drewsum/PIC32MZ_ETH_Demo/README.md

# PIC32MZ_ETH_Demo
A DIY dev board for PIC32MZ EF Ethernet Development
