drewsum/PIC32MZ_ETH_Demo/hdw/PIC32MZ_ETH_Demo/PIC32MZ_ETH_Demo.pdf

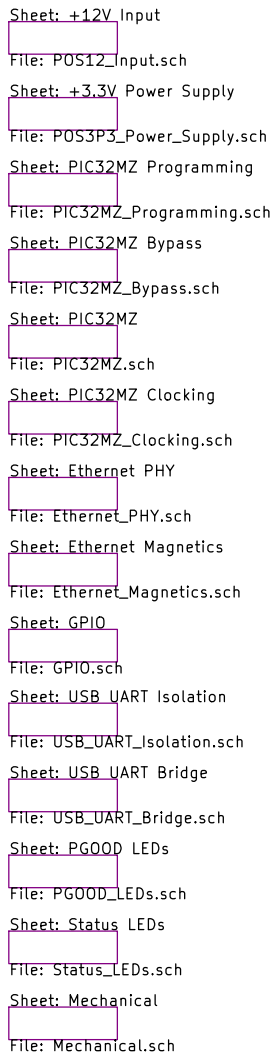
[picture p1: page 1]

File: PIC32MZ.sch Sheet: PIC32MZ Clocking

File: PIC32MZ_Clocking.sch Sheet: Ethernet PHY

File: Ethernet_PHY.sch Sheet: Ethernet Magnetics

File: Ethernet_Magnetics.sch Sheet: GPIO

File: GPIO.sch Sheet: USB UART Isolation File: USB_UART_Isolation.sch Sheet: USB UART Bridge

File: USB_UART_Bridge.sch Sheet: PGOOD LEDs File: PGOOD_LEDs.sch Sheet: Status LEDs File: Status_LEDs.sch Sheet: Mechanical File: Mechanical.sch

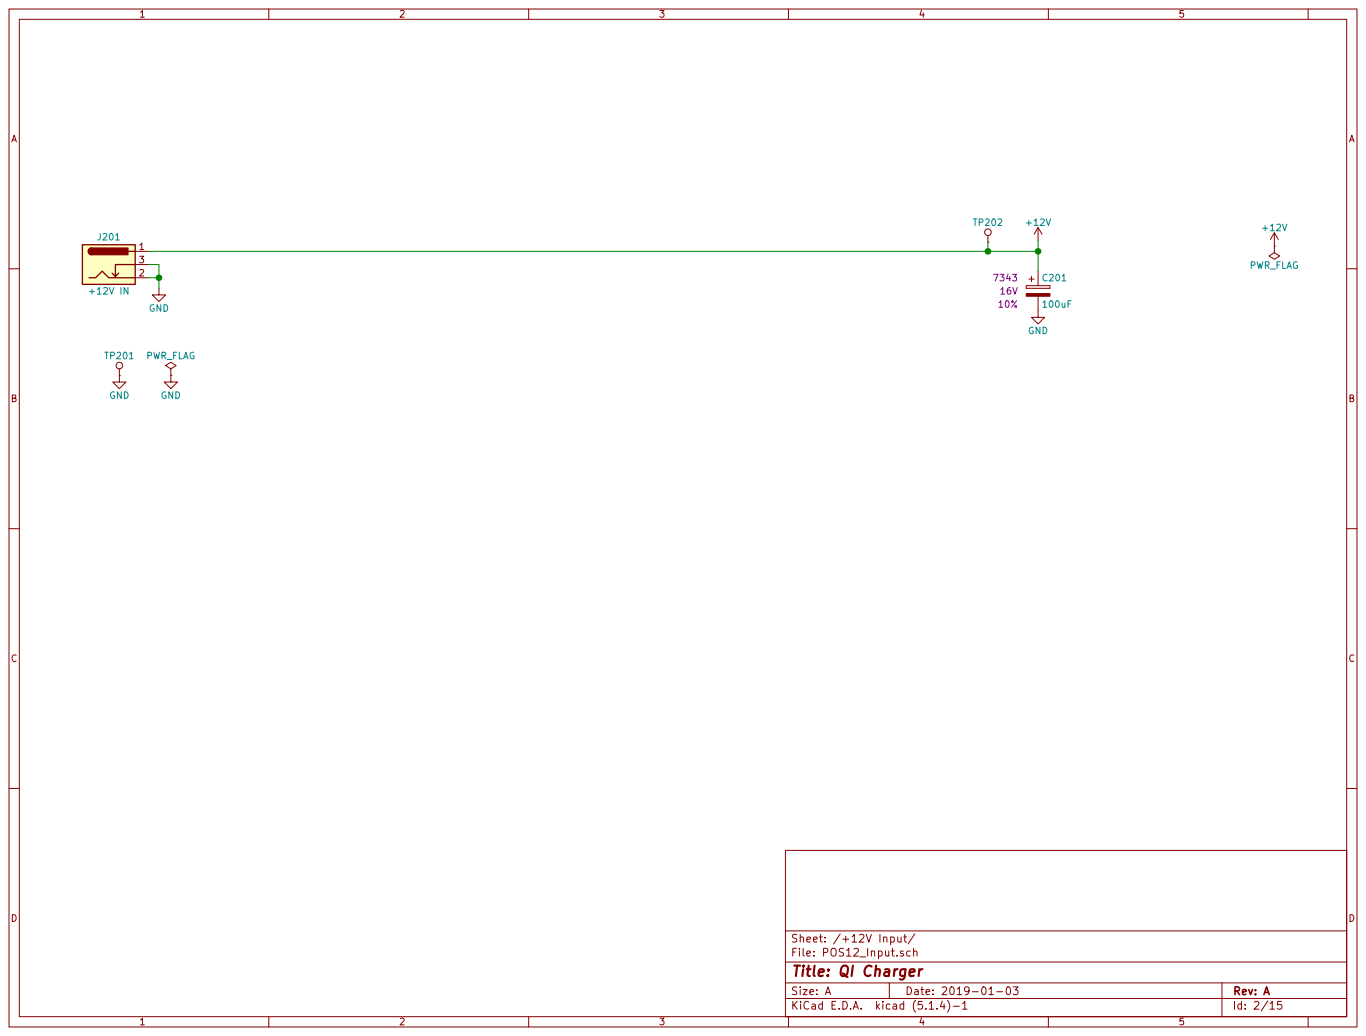
[picture p2: page 2]

Sheet: /+12V Input/
File: POS12_Input.sch
Id: 2/15 Title: QI Charger

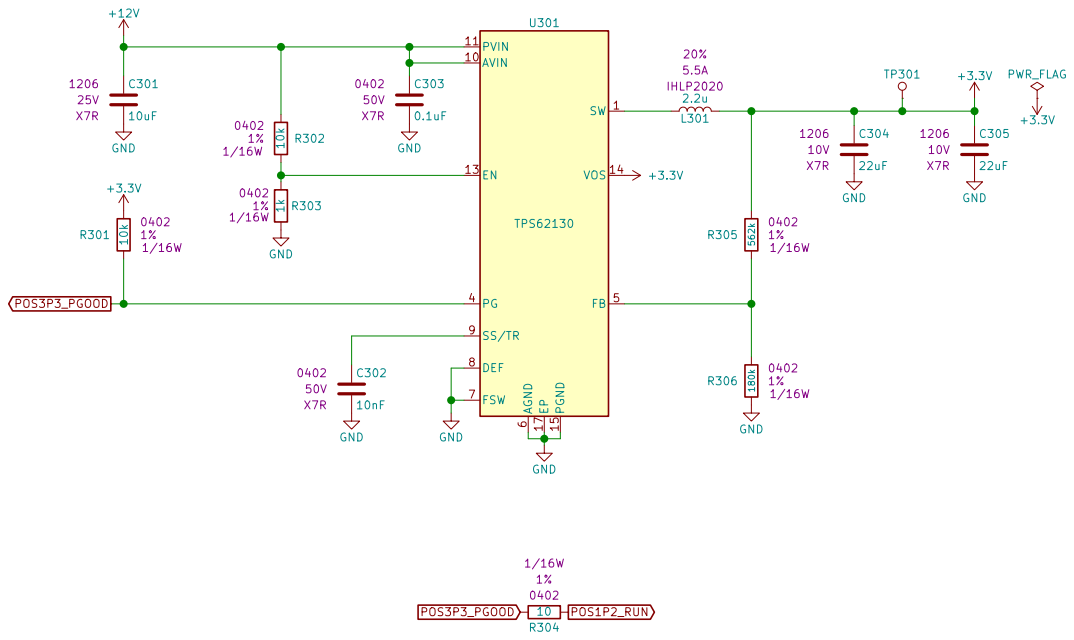
[picture p3: page 3]

6 FSW 7 DEF 8 SS/TR 9 U301 TPS62130 C305

Sheet: /+3.3V Power Supply/
File: POS3P3_Power_Supply.sch
Id: 3/15 Title: QI Charger

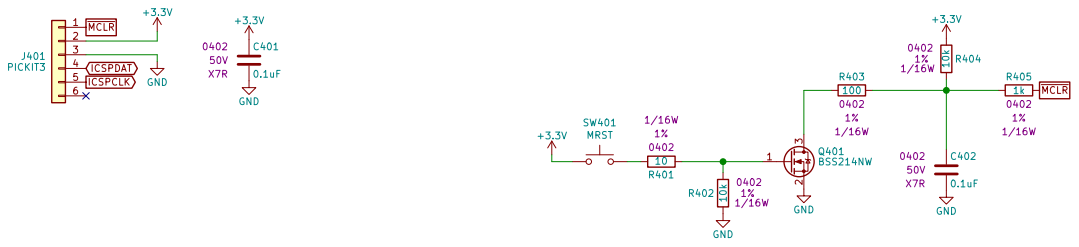
[picture p4: page 4]

Sheet: /PIC32MZ Programming/ Drew Maatman

File: PIC32MZ_Programming.sch
Id: 4/15 Title: VFD Clock

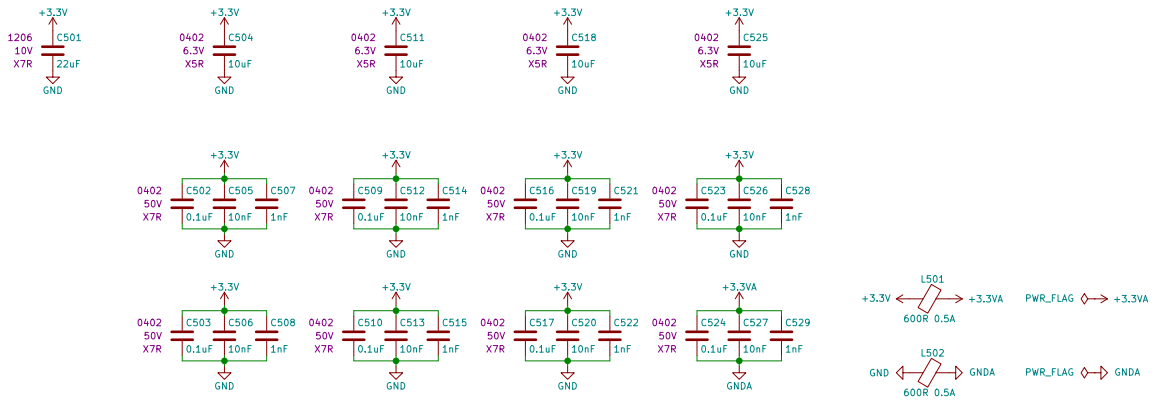
[picture p5: page 5]

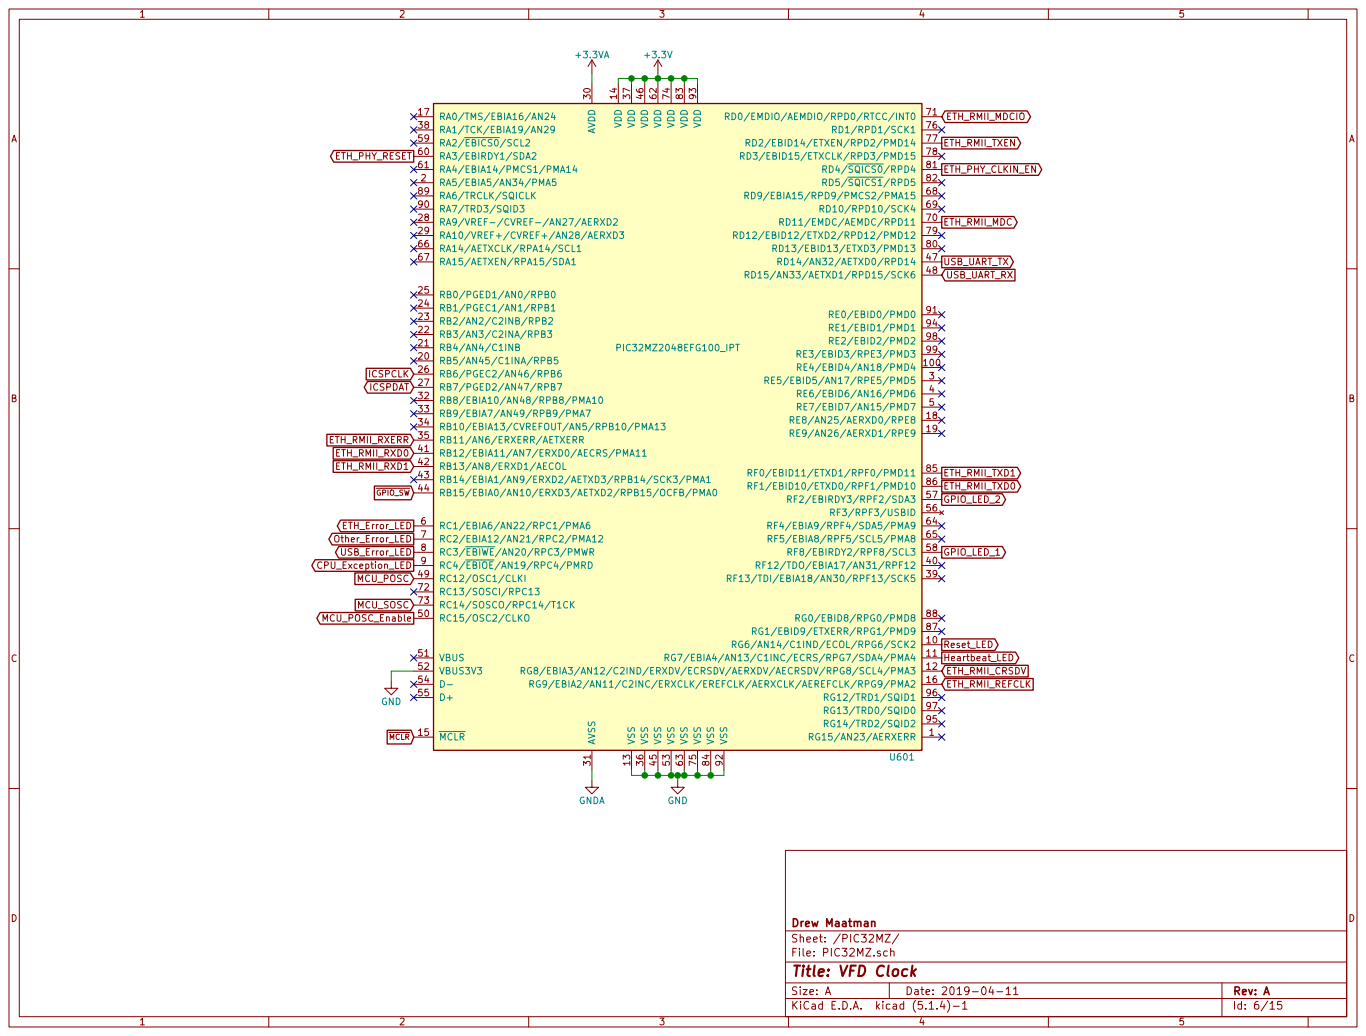
[picture p6: page 6]

Id: 6/15 Title: VFD Clock

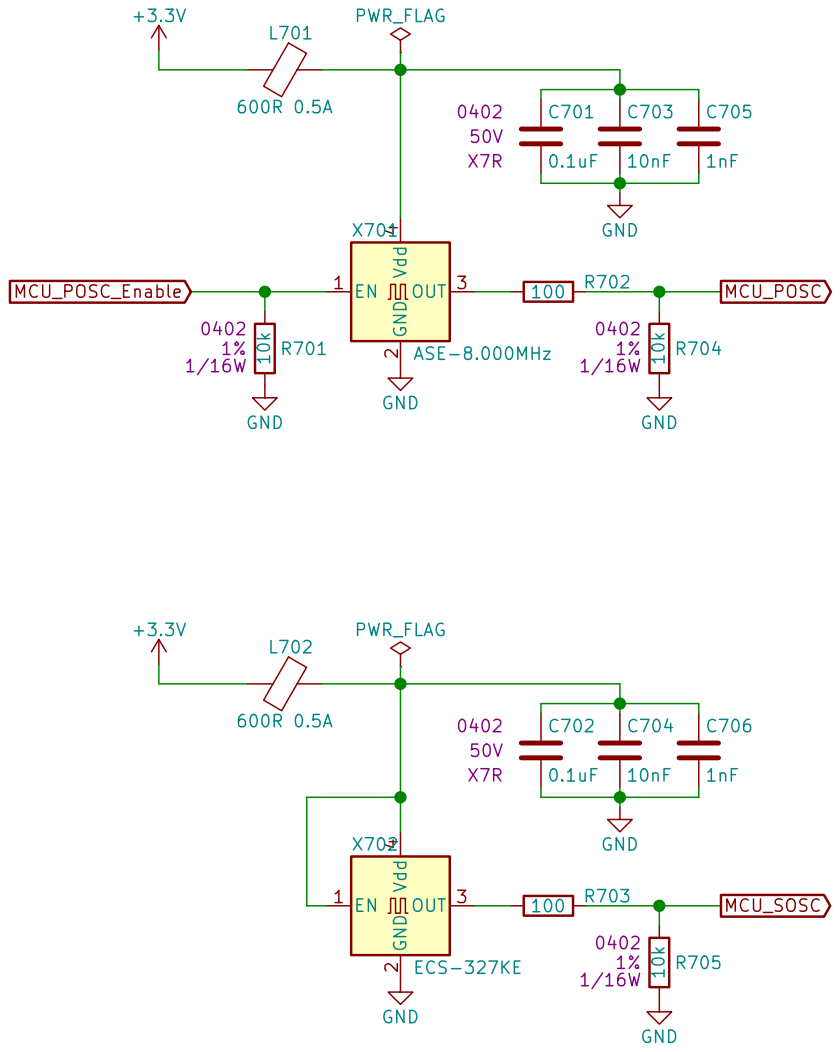
[picture p7: page 7]

2 OUT 3 Vdd X701 4 ASE-8.000MHz GND

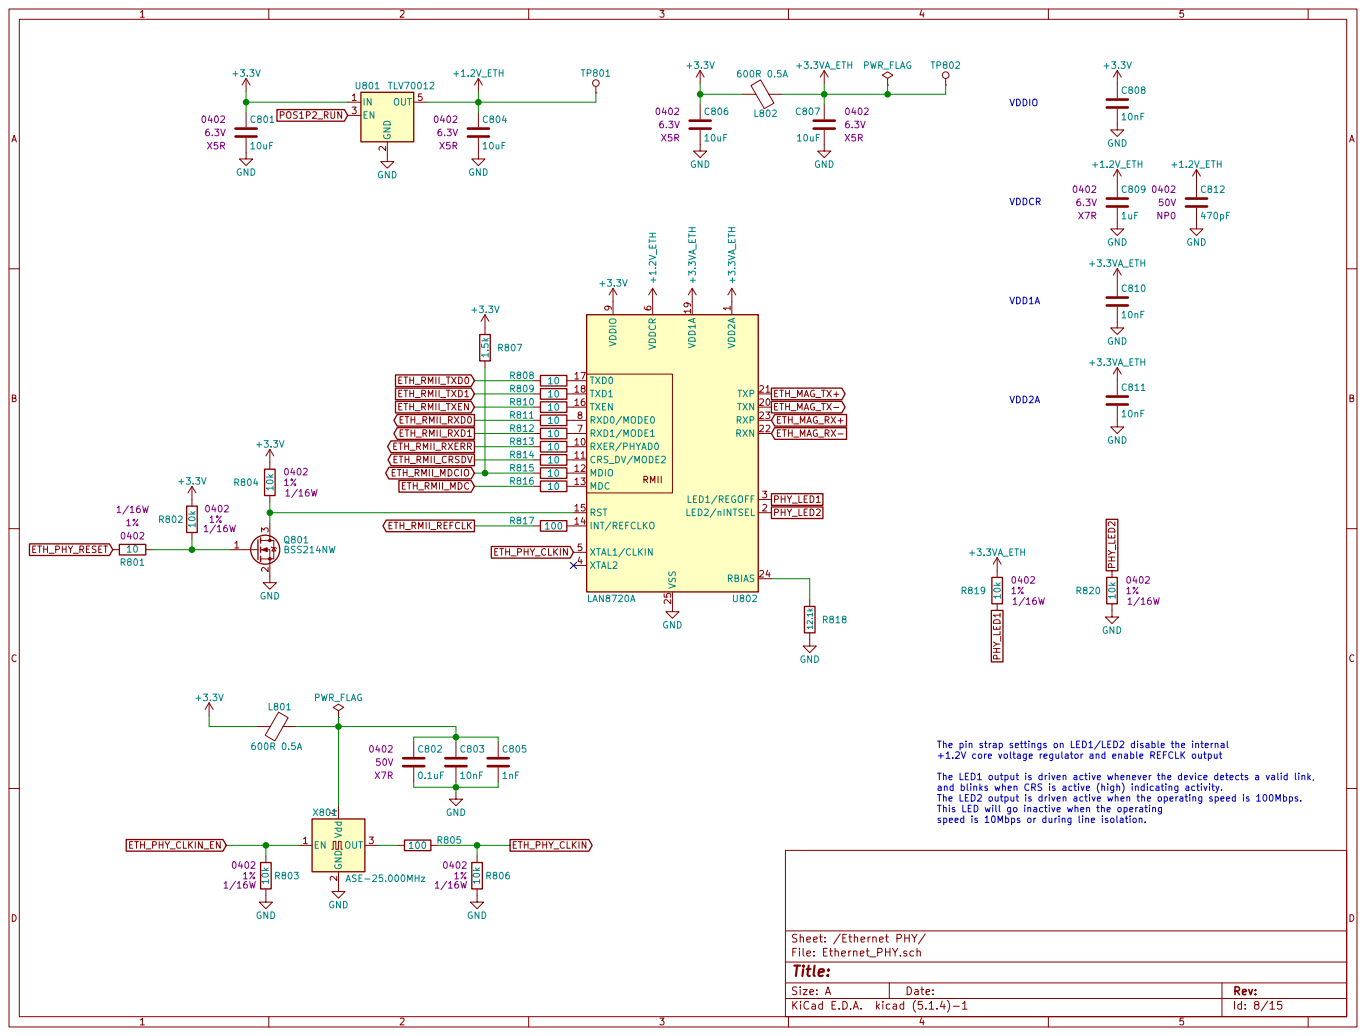
[picture p8: page 8]

The pin strap settings on LED1/LED2 disable the internal
+1.2V core voltage regulator and enable REFCLK output

The LED1 output is driven active whenever the device detects a valid link,
and blinks when CRS is active (high) indicating activity.
The LED2 output is driven active when the operating speed is 100Mbps.
This LED will go inactive when the operating
speed is 10Mbps or during line isolation.

File: Ethernet_PHY.sch Sheet: /Ethernet PHY/

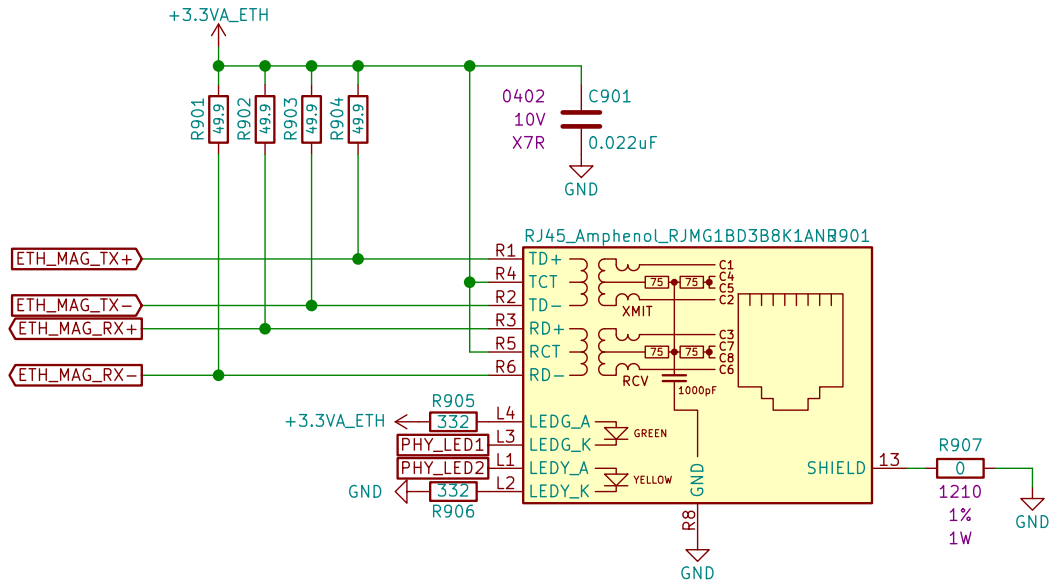
[picture p9: page 9]

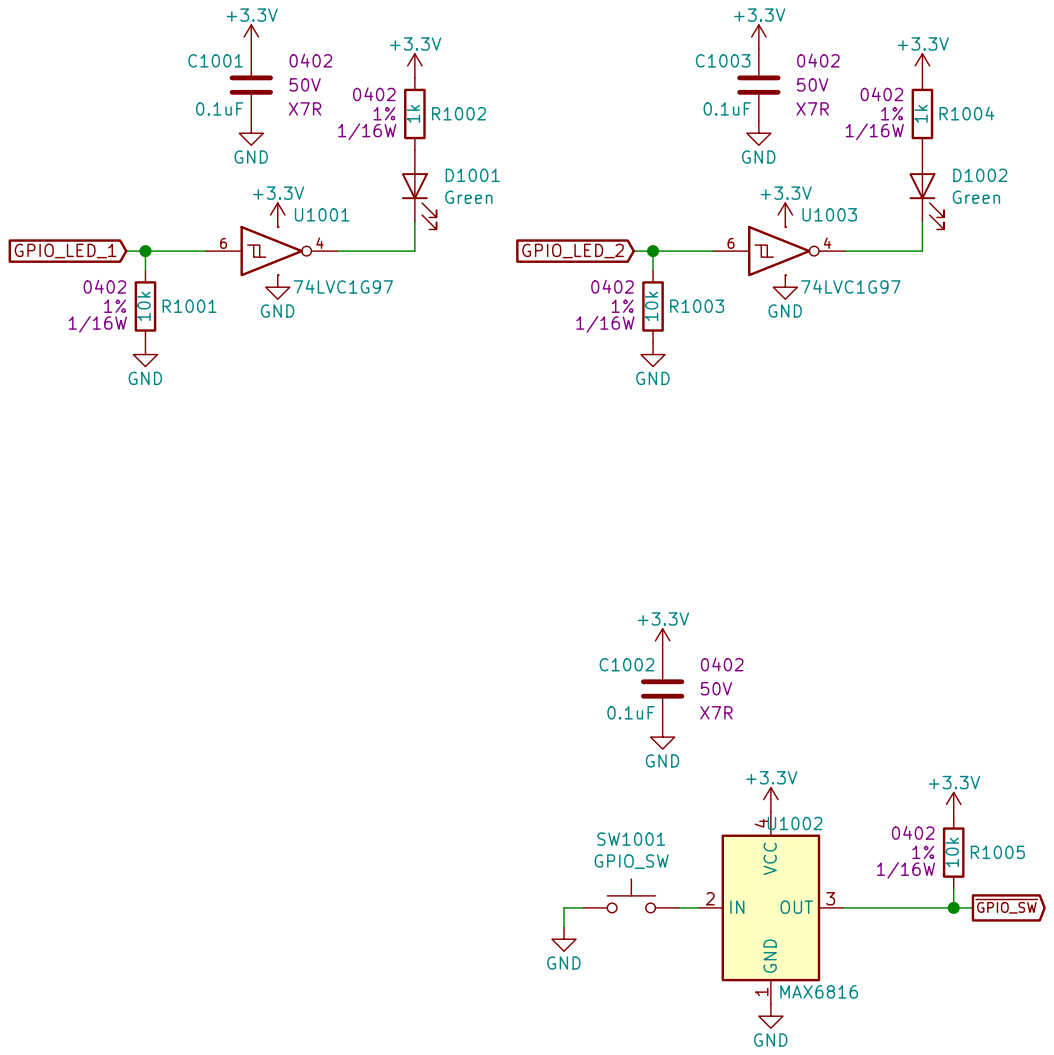
[picture p10: page 10]

Id: 10/15 Title: File: GPIO.sch Sheet: /GPIO/ GND

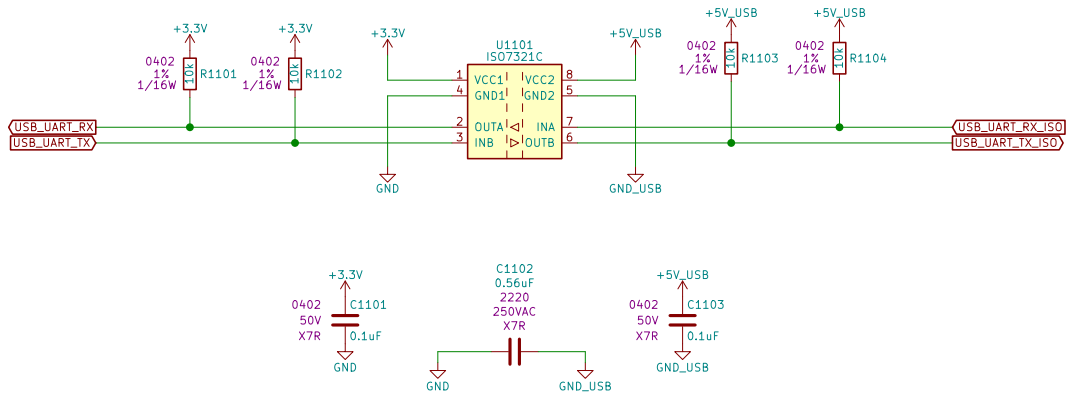
[picture p11: page 11]

Id: 11/15 Title: VFD Clock

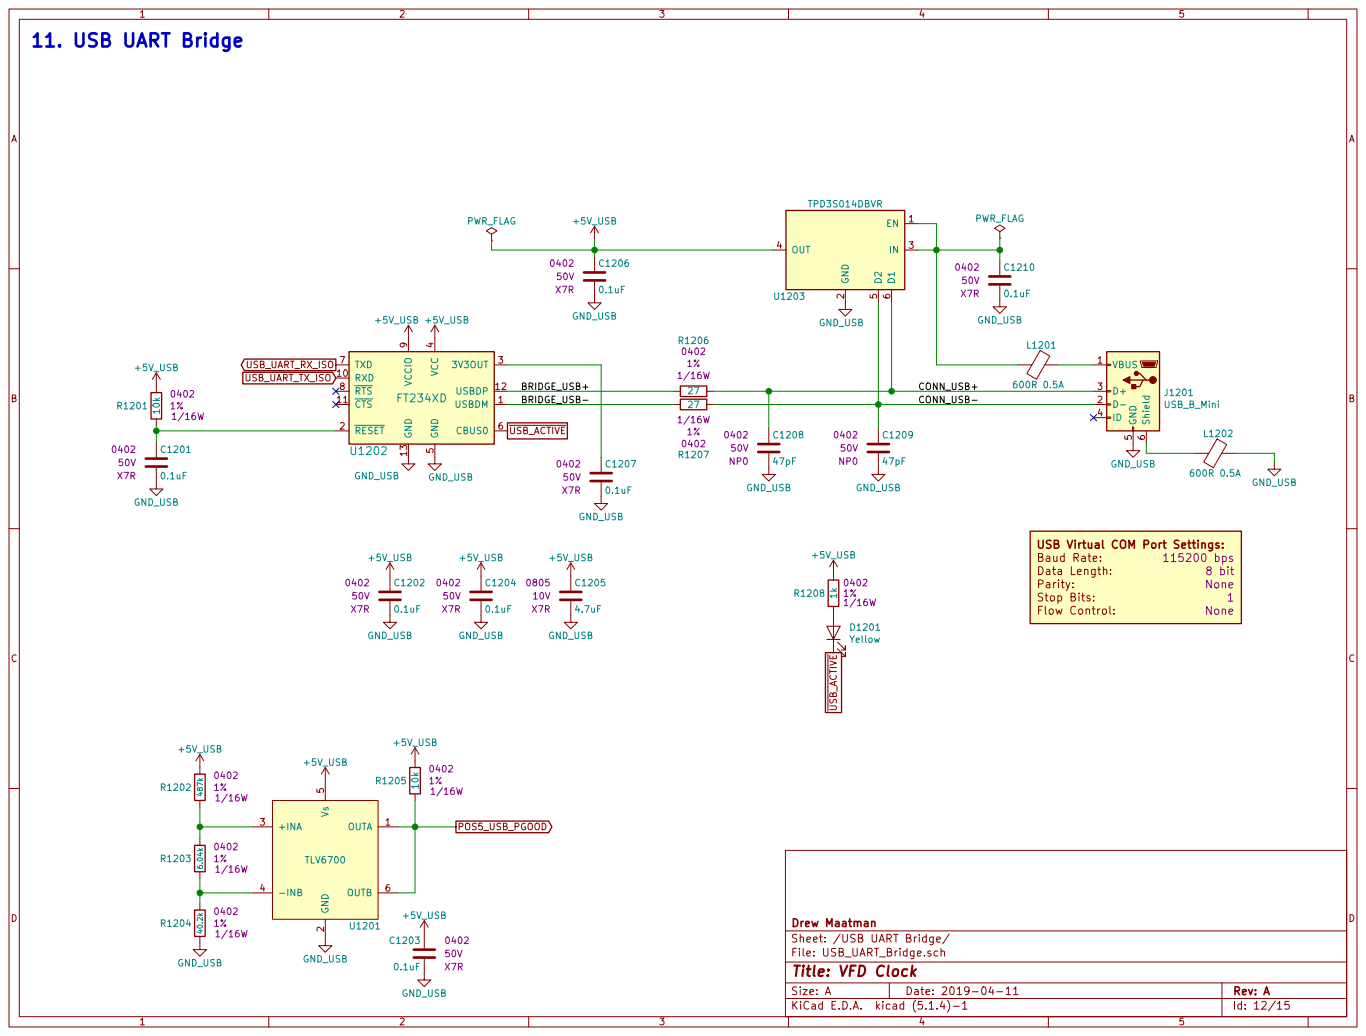
[picture p12: page 12]

USB Virtual COM Port Settings:

File: USB_UART_Bridge.sch
Id: 12/15 Title: VFD Clock

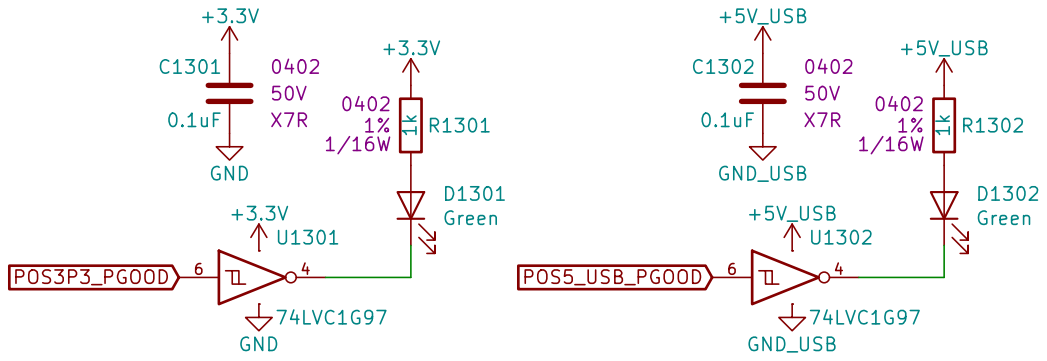
[picture p13: page 13]

File: PGOOD_LEDs.sch Sheet: /PGOOD LEDs/

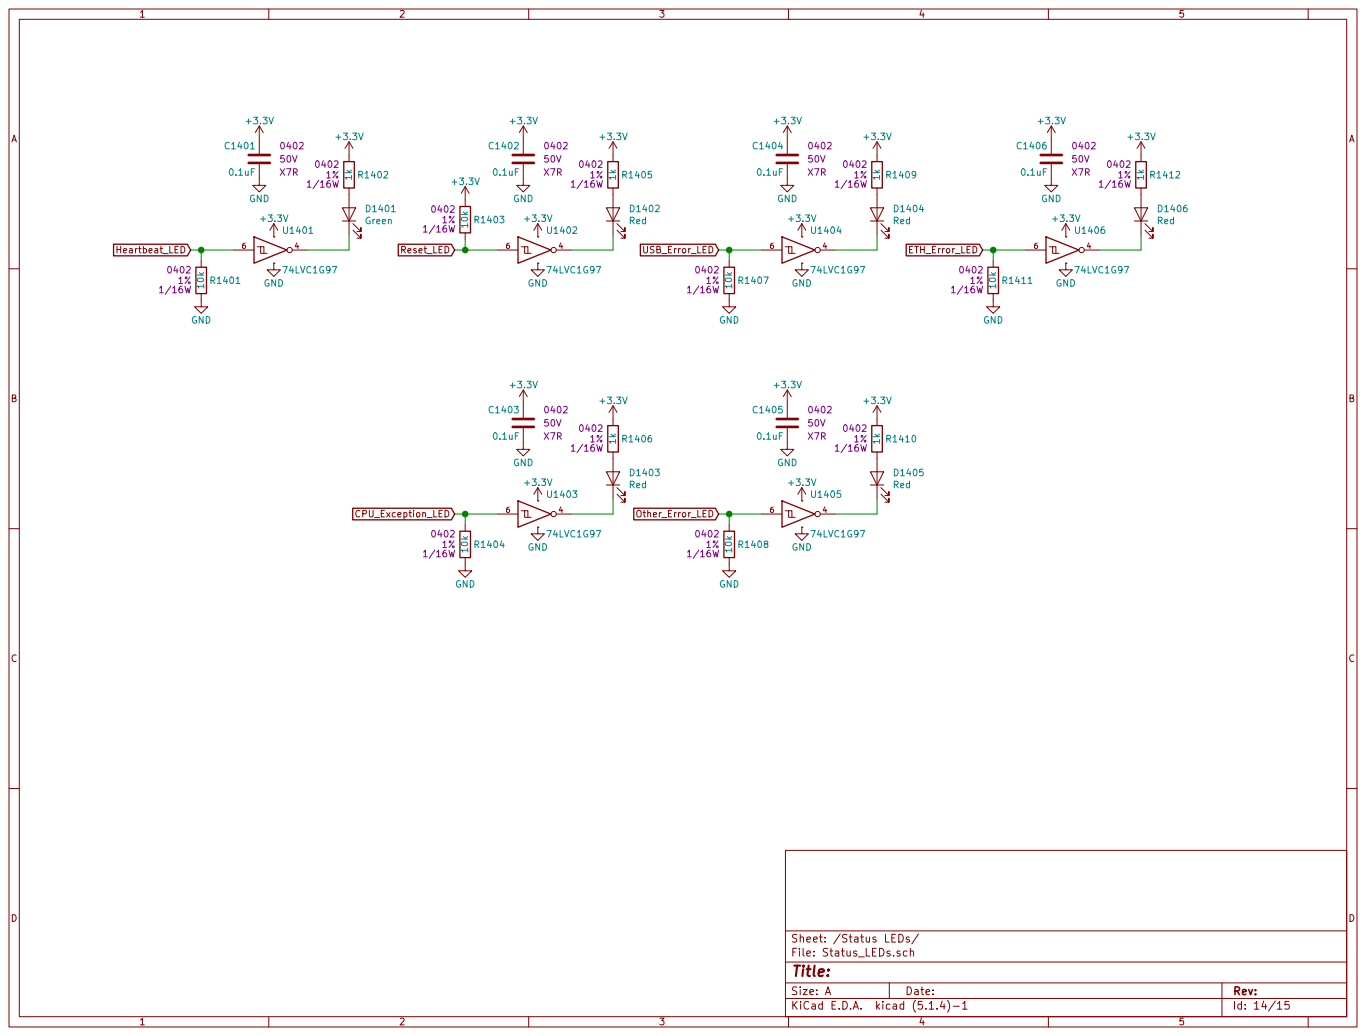
[picture p14: page 14]

File: Status_LEDs.sch Sheet: /Status LEDs/

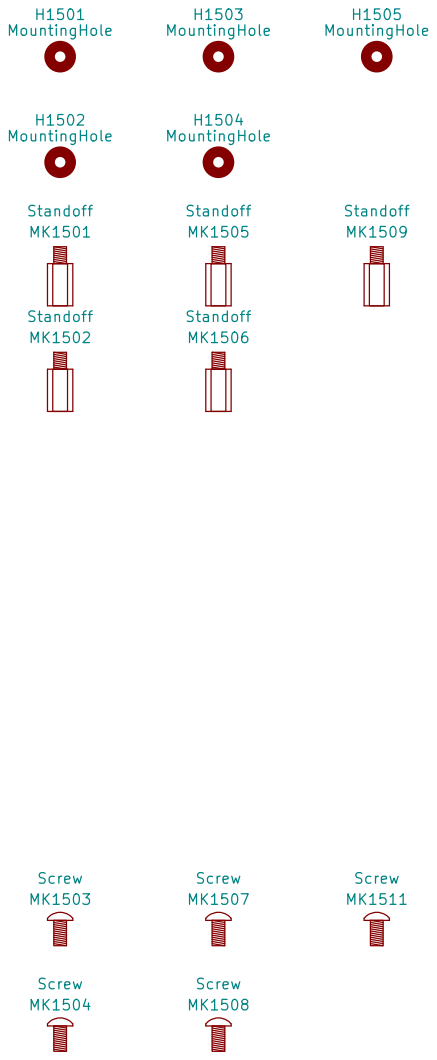
[picture p15: page 15]

File: Mechanical.sch Sheet: /Mechanical/ Drew Maatman

Id: 15/15 Title: VFD Clock
