drewsum/PIC32MZ_ETH_Demo/hdw/PIC32MZ_ETH_Demo/PIC32MZ_ETH_Demo.kicad_pcb

## KiCad design hdw/PIC32MZ_ETH_Demo/PIC32MZ_ETH_Demo.kicad_pcb (2020-06-10)

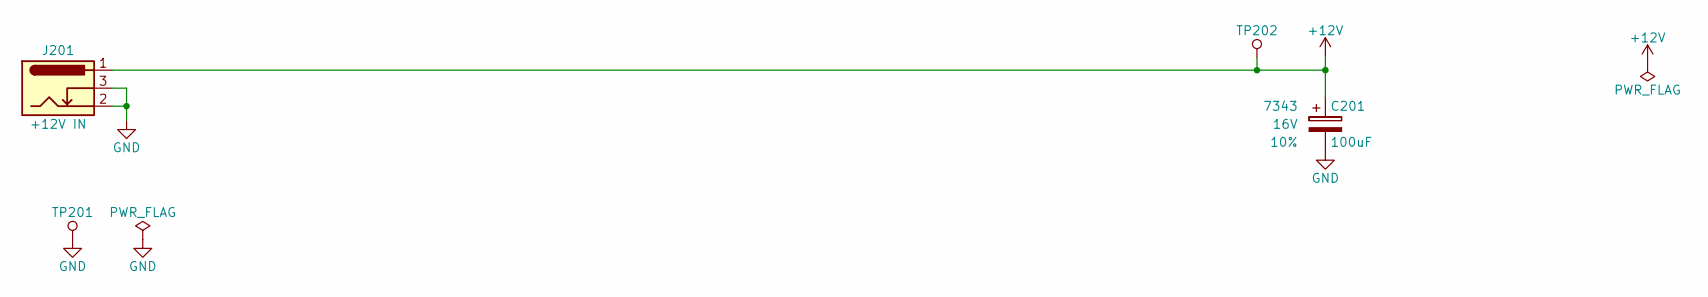
[picture p16: schematic POS12_Input.sch, QI Charger]

Parts:
C201: 100uF; CP_Tantalum_Case-X_EIA-7343-43_Reflow; Voltage 16V; Tolerance 10%; Digi-Key PN 718-1102-1-ND
J201: +12V IN; BARREL_JACK
TP201: TP; Pin_Header_Angled_1x01_Pitch2.54mm
TP202: TP; Test_Point

Connections:
+12V: C201.1, J201.1, TP202.1; also elsewhere on the board
GND: C201.2, J201.2, J201.3, TP201.1; also elsewhere on the board

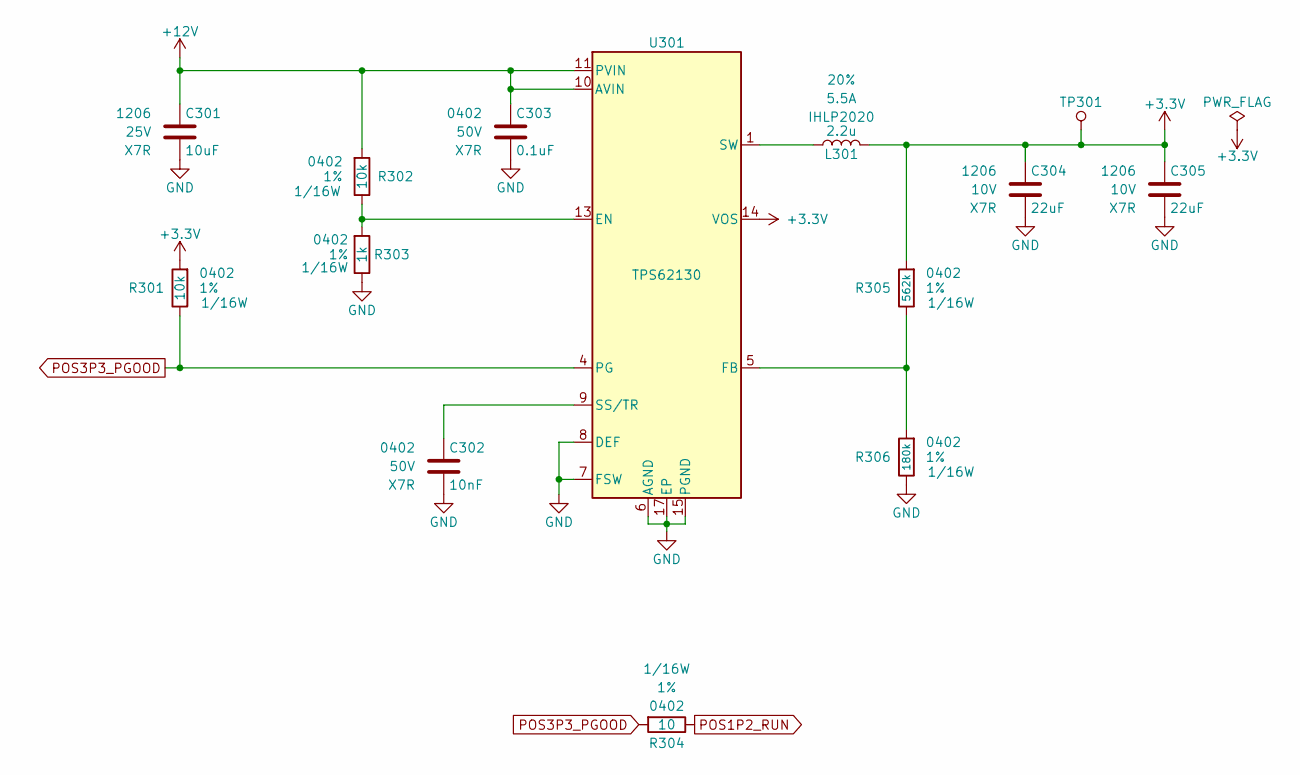
[picture p17: schematic POS3P3_Power_Supply.sch, QI Charger]

Parts:
C301: 10uF; C_1206; Voltage 25V; Digi-Key PN 1276-7031-1-ND
C302: 10nF; C_0402; Voltage 50V; Digi-Key PN 490-13295-1-ND
C303: 0.1uF; C_0402; Voltage 50V; Digi-Key PN 490-10701-1-ND
C304, C305: 22uF; C_1206; Voltage 10V; Digi-Key PN 1276-3148-1-ND
L301: 2.2u; L_Vishay_IHLP-2020; Tolerance 20%; Digi-Key PN 541-1236-1-ND
R301, R302: 10k; R_0402; Tolerance 1%; Digi-Key PN RMCF0402FT10K0CT-ND
R303: 1k; R_0402; Tolerance 1%; Digi-Key PN 541-1.00KLCT-ND
R304: 10; R_0402; Tolerance 1%; Digi-Key PN 541-3964-1-ND
R305: 562k; R_0402; Tolerance 1%; Digi-Key PN 541-562KLCT-ND
R306: 180k; R_0402; Tolerance 1%; Digi-Key PN 541-180KLCT-ND
TP301: TP; Test_Point
U301: TPS62130; QFN-16-1EP_3x3mm_Pitch0.5mm; Digi-Key PN 296-37878-1-ND

Connections:
+3V3: C304.1, C305.1, L301.2, R301.1, R305.1, TP301.1, U301.14 (VOS); also elsewhere on the board
+12V: C301.1, C303.1, R302.1, U301.10 (AVIN), U301.11 (PVIN), U301.12 (PVIN); also elsewhere on the board
GND: C301.2, C302.2, C303.2, C304.2, C305.2, R303.2, R306.2, U301.6 (AGND), U301.7 (FSW), U301.8 (DEF), U301.15 (PGND), U301.16 (PGND), U301.17 (EP); also elsewhere on the board
unnamed: C302.1, U301.9 (SS/TR)
unnamed: L301.1, U301.1 (SW), U301.2 (SW), U301.3 (SW)
unnamed: R302.2, R303.1, U301.13 (EN)
unnamed: R305.2, R306.1, U301.5 (FB)
POS1P2_RUN: R304.2; also elsewhere on the board
POS3P3_PGOOD: R301.2, R304.1, U301.4 (PG); also elsewhere on the board

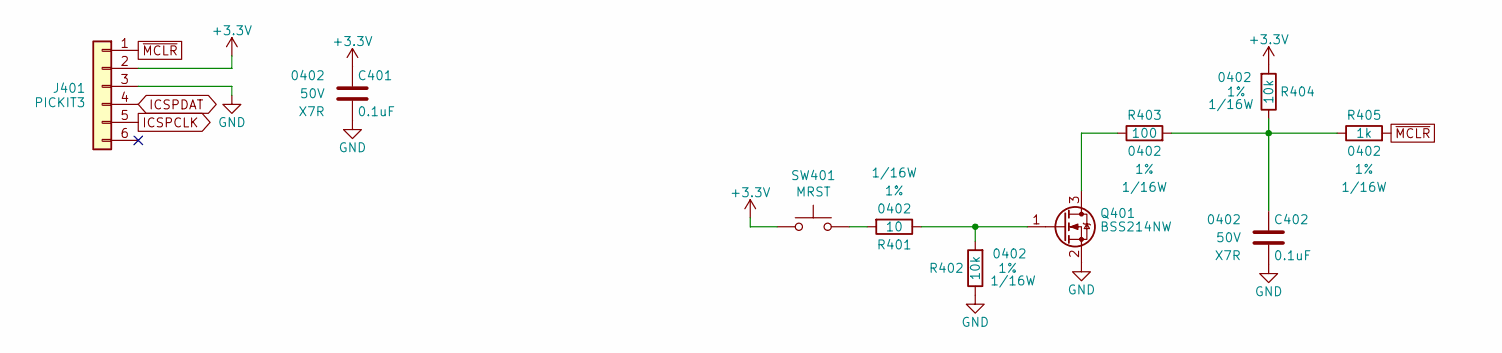
[picture p18: schematic PIC32MZ_Programming.sch, VFD Clock]

Parts:
C401, C402: 0.1uF; C_0402; Voltage 50V; Digi-Key PN 490-10701-1-ND
J401: PICKIT3; PICKIT3_Header
Q401: BSS214NW; SOT-323_SC-70; Digi-Key PN BSS214NWH6327XTSA1CT-ND
R401: 10; R_0402; Tolerance 1%; Digi-Key PN 541-3964-1-ND
R402, R404: 10k; R_0402; Tolerance 1%; Digi-Key PN RMCF0402FT10K0CT-ND
R403: 100; R_0402; Tolerance 1%; Digi-Key PN 541-100LCT-ND
R405: 1k; R_0402; Tolerance 1%; Digi-Key PN 541-1.00KLCT-ND
SW401: MRST; SW_PUSH_6mm

Connections:
+3V3: C401.1, J401.2, R404.1, SW401.1; also elsewhere on the board
GND: C401.2, C402.2, J401.3, Q401.2 (S), R402.2; also elsewhere on the board
ICSPCLK: J401.5; also elsewhere on the board
ICSPDAT: J401.4; also elsewhere on the board
unnamed: C402.1, R403.1, R404.2, R405.2
unnamed: Q401.1 (G), R401.2, R402.1
unnamed: Q401.3 (D), R403.2
unnamed: R401.1, SW401.2
~MCLR: J401.1, R405.1; also elsewhere on the board

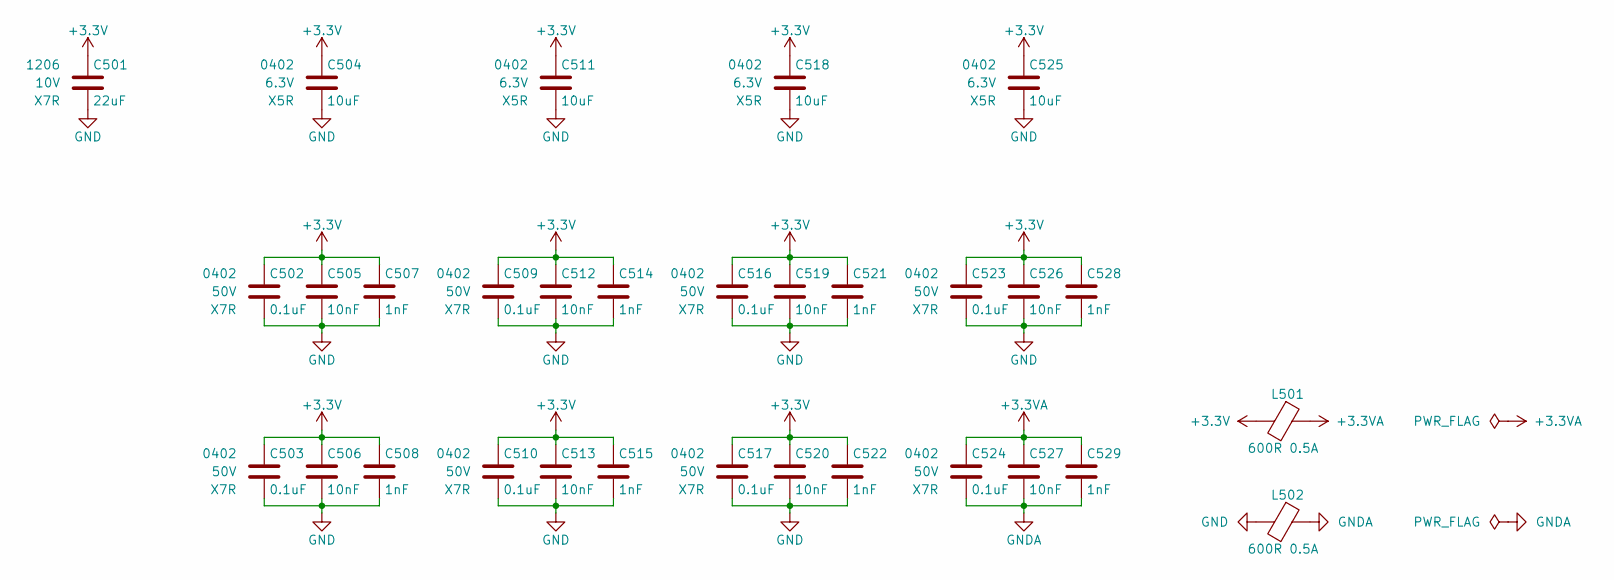
[picture p19: schematic PIC32MZ_Bypass.sch]

Parts:
C501: 22uF; C_1206; Voltage 10V; Digi-Key PN 1276-3148-1-ND
C502, C503, C509, C510, C516, C517, C523, C524: 0.1uF; C_0402; Voltage 50V; Digi-Key PN 490-10701-1-ND
C504, C511, C518, C525: 10uF; C_0402; Voltage 6.3V; Digi-Key PN 490-13211-1-ND
C505, C506, C512, C513, C519, C520, C526, C527: 10nF; C_0402; Voltage 50V; Digi-Key PN 490-13295-1-ND
C507, C508, C514, C515, C521, C522, C528, C529: 1nF; C_0402; Voltage 50V; Digi-Key PN 399-1032-1-ND
L501, L502: 600R 0.5A; L_0402; Digi-Key PN 490-5441-1-ND

Connections:
+3.3VA: C524.1, C527.1, C529.1, L501.1; also elsewhere on the board
+3V3: C501.1, C502.1, C503.1, C504.1, C505.1, C506.1, C507.1, C508.1, C509.1, C510.1, C511.1, C512.1, C513.1, C514.1, C515.1, C516.1, C517.1, C518.1, C519.1, C520.1, C521.1, C522.1, C523.1, C525.1, C526.1, C528.1, L501.2; also elsewhere on the board
GND: C501.2, C502.2, C503.2, C504.2, C505.2, C506.2, C507.2, C508.2, C509.2, C510.2, C511.2, C512.2, C513.2, C514.2, C515.2, C516.2, C517.2, C518.2, C519.2, C520.2, C521.2, C522.2, C523.2, C525.2, C526.2, C528.2, L502.2; also elsewhere on the board
GNDA: C524.2, C527.2, C529.2, L502.1; also elsewhere on the board

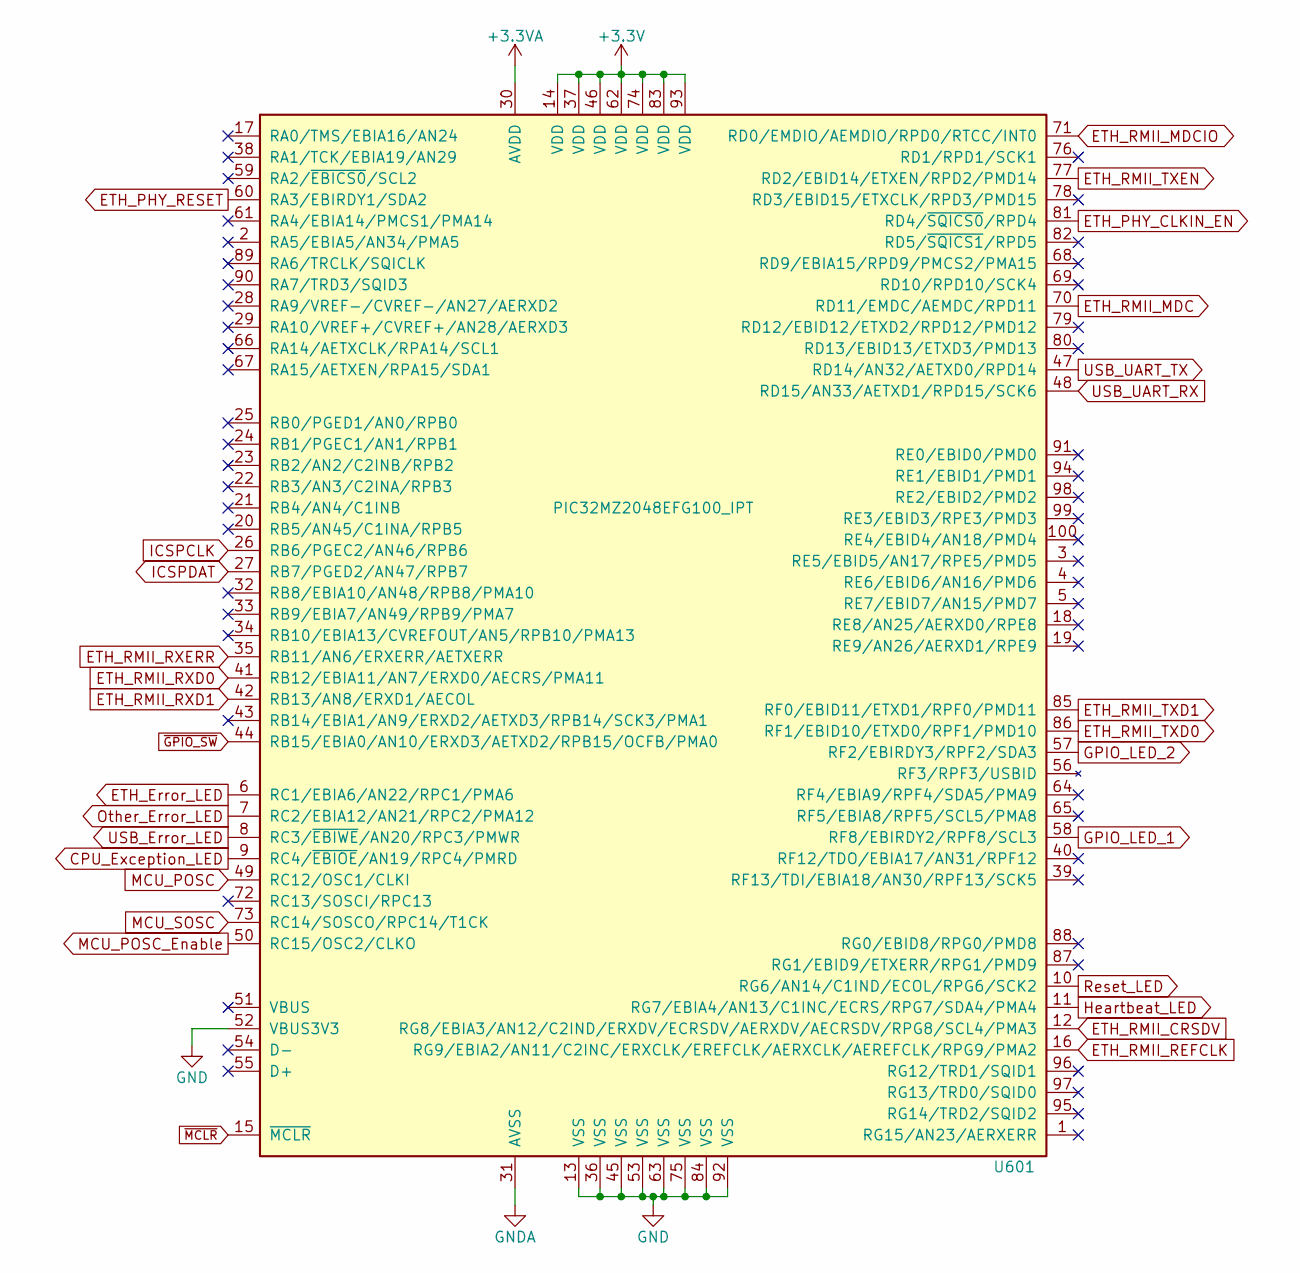
[picture p20: schematic PIC32MZ.sch, VFD Clock]

Parts:
U601: PIC32MZ2048EFG100_IPT; TQFP-100_14x14mm_Pitch0.5mm; Digi-Key PN PIC32MZ2048EFG100-I/PT-ND

Connections:
+3.3VA: U601.30 (AVDD); also elsewhere on the board
+3V3: U601.14 (VDD), U601.37 (VDD), U601.46 (VDD), U601.62 (VDD), U601.74 (VDD), U601.83 (VDD), U601.93 (VDD); also elsewhere on the board
CPU_Exception_LED: U601.9 (RC4/~EBIOE~/AN19/RPC4/PMRD); also elsewhere on the board
ETH_Error_LED: U601.6 (RC1/EBIA6/AN22/RPC1/PMA6); also elsewhere on the board
ETH_PHY_CLKIN_EN: U601.81 (RD4/~SQICS0~/RPD4); also elsewhere on the board
ETH_PHY_RESET: U601.60 (RA3/EBIRDY1/SDA2); also elsewhere on the board
ETH_RMII_CRSDV: U601.12 (RG8/EBIA3/AN12/C2IND/ERXDV/ECRSDV/AERXD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); also elsewhere on the board
ETH_RMII_MDC: U601.70 (RD11/EMDC/AEMDC/RPD11); also elsewhere on the board
ETH_RMII_MDCIO: U601.71 (RD0/EMDIO/AEMDIO/RPD0/RTCC/INT0); also elsewhere on the board
ETH_RMII_REFCLK: U601.16 (RG9/EBIA2/AN11/C2INC/ERXCLK/EREFCLK/AER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); also elsewhere on the board
ETH_RMII_RXD0: U601.41 (RB12/EBIA11/AN7/ERXD0/AECRS/PMA11); also elsewhere on the board
ETH_RMII_RXD1: U601.42 (RB13/AN8/ERXD1/AECOL); also elsewhere on the board
ETH_RMII_RXERR: U601.35 (RB11/AN6/ERXERR/AETXERR); also elsewhere on the board
ETH_RMII_TXD0: U601.86 (RF1/EBID10/ETXD0/RPF1/PMD10); also elsewhere on the board
ETH_RMII_TXD1: U601.85 (RF0/EBID11/ETXD1/RPF0/PMD11); also elsewhere on the board
ETH_RMII_TXEN: U601.77 (RD2/EBID14/ETXEN/RPD2/PMD14); also elsewhere on the board
GND: U601.13 (VSS), U601.36 (VSS), U601.45 (VSS), U601.52 (VBUS3V3), U601.53 (VSS), U601.63 (VSS), U601.75 (VSS), U601.84 (VSS), U601.92 (VSS); also elsewhere on the board
GNDA: U601.31 (AVSS); also elsewhere on the board
GPIO_LED_1: U601.58 (RF8/EBIRDY2/RPF8/SCL3); also elsewhere on the board
GPIO_LED_2: U601.57 (RF2/EBIRDY3/RPF2/SDA3); also elsewhere on the board
Heartbeat_LED: U601.11 (RG7/EBIA4/AN13/C1INC/ECRS/RPG7/SDA4/PMA4); also elsewhere on the board
ICSPCLK: U601.26 (RB6/PGEC2/AN46/RPB6); also elsewhere on the board
ICSPDAT: U601.27 (RB7/PGED2/AN47/RPB7); also elsewhere on the board
MCU_POSC: U601.49 (RC12/OSC1/CLKI); also elsewhere on the board
MCU_POSC_Enable: U601.50 (RC15/OSC2/CLKO); also elsewhere on the board
MCU_SOSC: U601.73 (RC14/SOSCO/RPC14/T1CK); also elsewhere on the board
Other_Error_LED: U601.7 (RC2/EBIA12/AN21/RPC2/PMA12); also elsewhere on the board
Reset_LED: U601.10 (RG6/AN14/C1IND/ECOL/RPG6/SCK2); also elsewhere on the board
USB_Error_LED: U601.8 (RC3/~EBIWE~/AN20/RPC3/PMWR); also elsewhere on the board
USB_UART_RX: U601.48 (RD15/AN33/AETXD1/RPD15/SCK6); also elsewhere on the board
USB_UART_TX: U601.47 (RD14/AN32/AETXD0/RPD14); also elsewhere on the board
~GPIO_SW: U601.44 (RB15/EBIA0/AN10/ERXD3/AETXD2/RPB15/OCFB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); also elsewhere on the board
~MCLR: U601.15 (~MCLR~); also elsewhere on the board

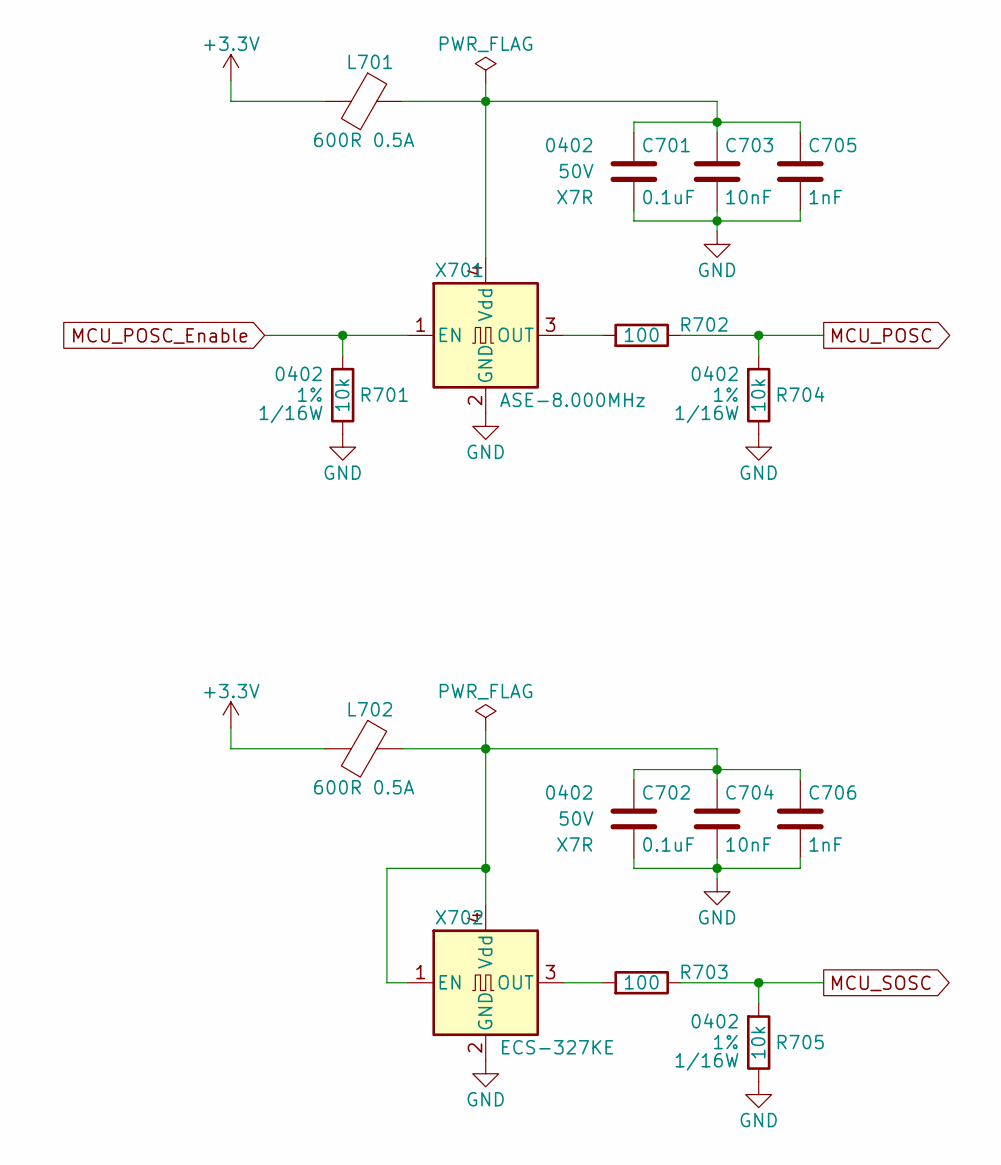
[picture p21: schematic PIC32MZ_Clocking.sch]

Parts:
C701, C702: 0.1uF; C_0402; Voltage 50V; Digi-Key PN 490-10701-1-ND
C703, C704: 10nF; C_0402; Voltage 50V; Digi-Key PN 490-13295-1-ND
C705, C706: 1nF; C_0402; Voltage 50V; Digi-Key PN 399-1032-1-ND
L701, L702: 600R 0.5A; L_0402; Digi-Key PN 490-5441-1-ND
R701, R704, R705: 10k; R_0402; Tolerance 1%; Digi-Key PN RMCF0402FT10K0CT-ND
R702, R703: 100; R_0402; Tolerance 1%; Digi-Key PN 541-100LCT-ND
X701: ASE-8.000MHz; Oscillator_SMD_Abracon_ASE-4Pin_3.2x2.5mm; Digi-Key PN 535-9558-1-ND
X702: ECS-327KE; Digi-Key PN XC1751CT-ND

Connections:
+3V3: L701.2, L702.2; also elsewhere on the board
GND: C701.2, C702.2, C703.2, C704.2, C705.2, C706.2, R701.2, R704.2, R705.2, X701.2 (GND), X702.2 (GND); also elsewhere on the board
MCU_POSC: R702.2, R704.1; also elsewhere on the board
MCU_POSC_Enable: R701.1, X701.1 (EN); also elsewhere on the board
MCU_SOSC: R703.2, R705.1; also elsewhere on the board
unnamed: C701.1, C703.1, C705.1, L701.1, X701.4 (Vdd)
unnamed: C702.1, C704.1, C706.1, L702.1, X702.1 (EN), X702.4 (Vdd)
unnamed: R702.1, X701.3 (OUT)
unnamed: R703.1, X702.3 (OUT)

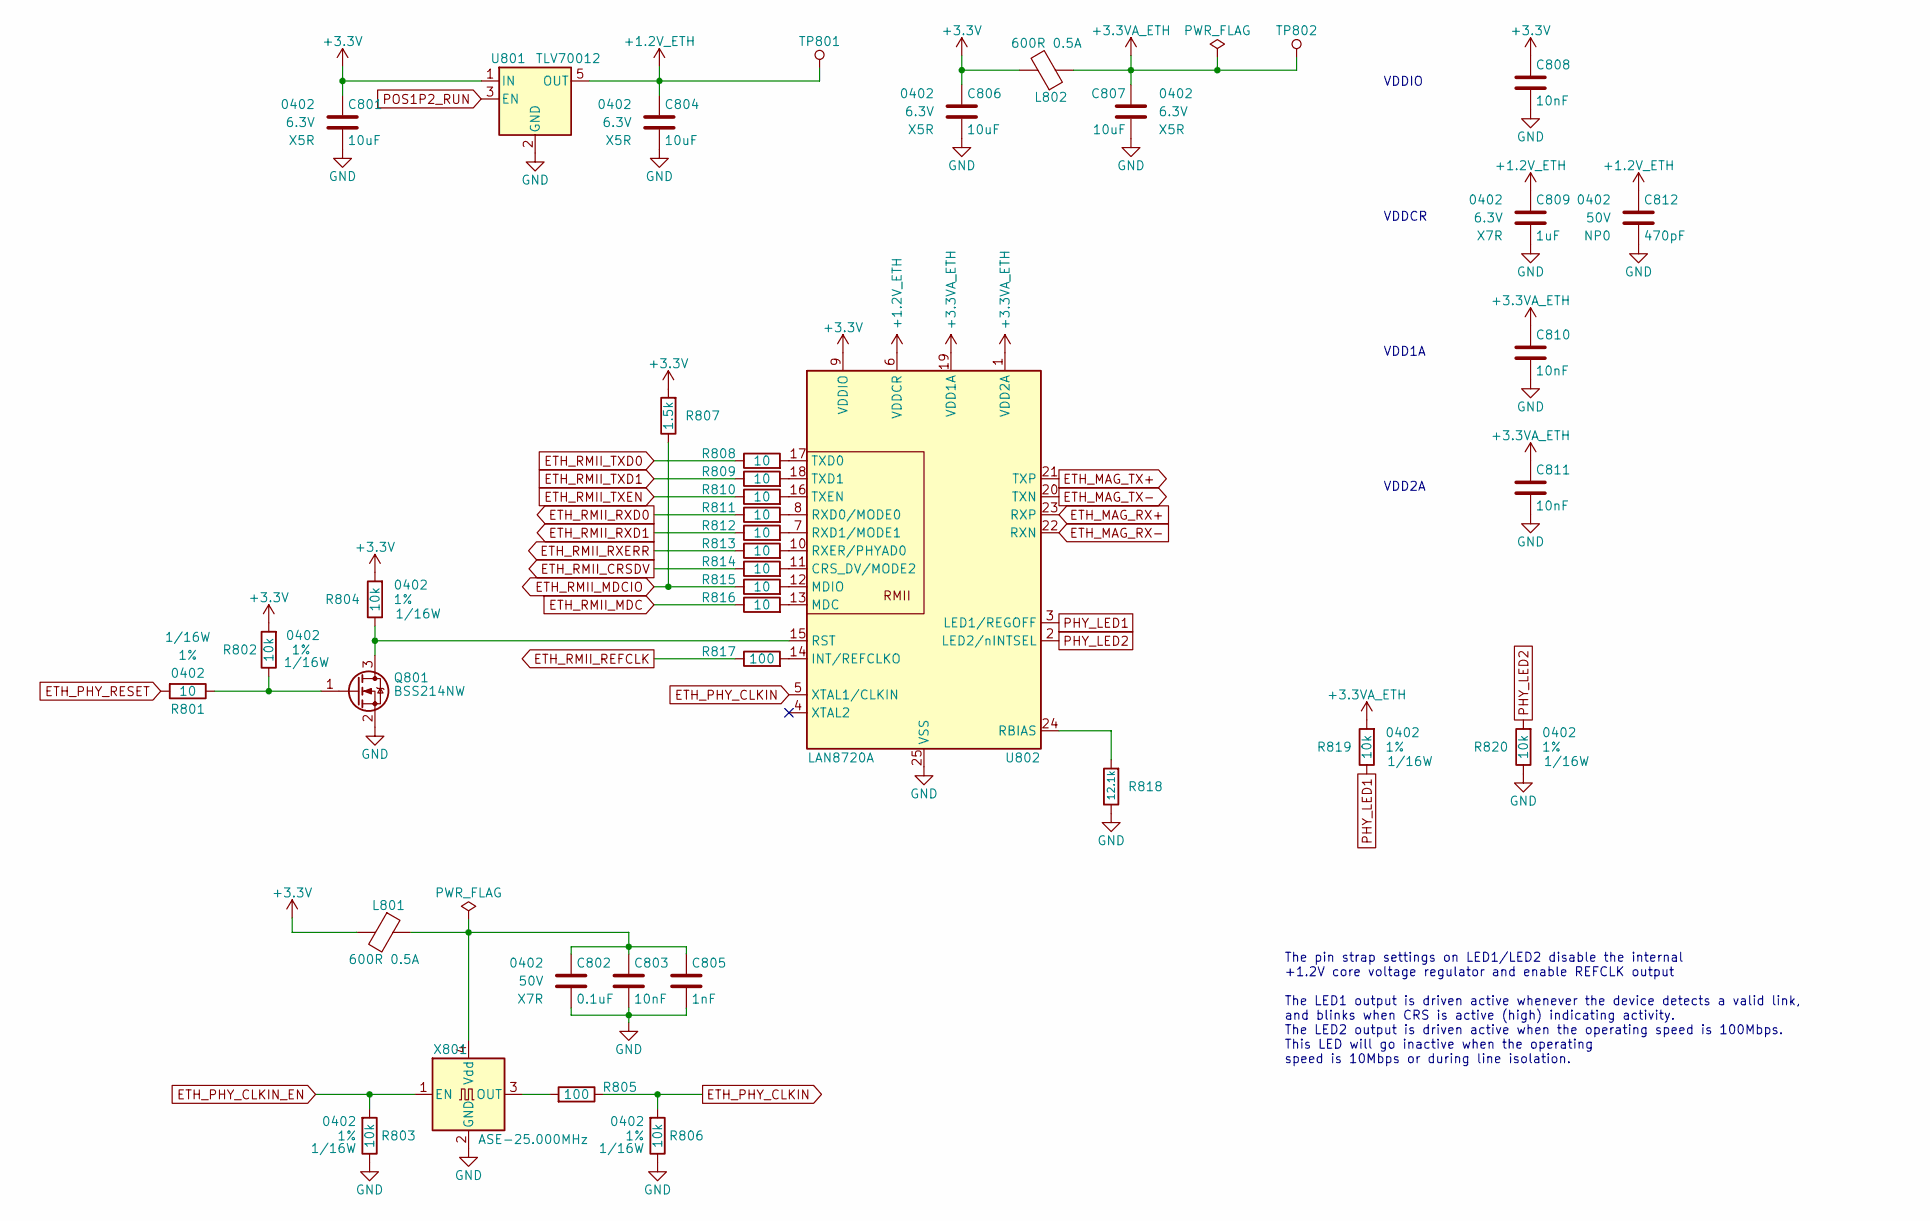
[picture p22: schematic Ethernet_PHY.sch]

Parts:
C801, C804, C806, C807: 10uF; C_0402; Voltage 6.3V; Digi-Key PN 490-13211-1-ND
C802: 0.1uF; C_0402; Voltage 50V; Digi-Key PN 490-10701-1-ND
C803, C808, C810, C811: 10nF; C_0402; Voltage 50V; Digi-Key PN 490-13295-1-ND
C805: 1nF; C_0402; Voltage 50V; Digi-Key PN 399-1032-1-ND
C809: 1uF; C_0402; Voltage 6.3V; Digi-Key PN 490-9665-1-ND
C812: 470pF; C_0402; Voltage 50V; Digi-Key PN 399-1025-1-ND
L801, L802: 600R 0.5A; L_0402; Digi-Key PN 490-5441-1-ND
Q801: BSS214NW; SOT-323_SC-70; Digi-Key PN BSS214NWH6327XTSA1CT-ND
R801, R808, R809, R810, R811, R812, R813, R814, R815, R816: 10; R_0402; Tolerance 1%; Digi-Key PN 541-3964-1-ND
R802, R803, R804, R806, R819, R820: 10k; R_0402; Tolerance 1%; Digi-Key PN RMCF0402FT10K0CT-ND
R805, R817: 100; R_0402; Tolerance 1%; Digi-Key PN 541-100LCT-ND
R807: 1.5k; R_0402; Tolerance 1%; Digi-Key PN 541-1.50KLCT-ND
R818: 12.1k; R_0402; Tolerance 1%; Digi-Key PN 541-CRCW040212K1FKTDCT-ND
TP801, TP802: TP_Pad; Test_Point
U801: TLV70012; SOT-353_SC-70-5; Digi-Key PN 296-27438-1-ND
U802: LAN8720A; QFN-24-1EP_4x4mm_P0.5mm_EP2.6x2.6mm; Digi-Key PN LAN8720A-CP-CT-ND
X801: ASE-25.000MHz; Oscillator_SMD_Abracon_ASE-4Pin_3.2x2.5mm; Digi-Key PN 535-13429-1-ND

Connections:
+1.2V_ETH: C804.1, C809.1, C812.1, TP801.1, U801.5 (OUT), U802.6 (VDDCR)
+3.3VA_ETH: C807.1, C810.1, C811.1, L802.1, R819.1, TP802.1, U802.1 (VDD2A), U802.19 (VDD1A); also elsewhere on the board
+3V3: C801.1, C806.1, C808.1, L801.2, L802.2, R802.1, R804.1, R807.1, U801.1 (IN), U802.9 (VDDIO); also elsewhere on the board
ETH_MAG_RX+: U802.23 (RXP); also elsewhere on the board
ETH_MAG_RX-: U802.22 (RXN); also elsewhere on the board
ETH_MAG_TX+: U802.21 (TXP); also elsewhere on the board
ETH_MAG_TX-: U802.20 (TXN); also elsewhere on the board
ETH_PHY_CLKIN: R805.2, R806.1, U802.5 (XTAL1/CLKIN)
ETH_PHY_CLKIN_EN: R803.1, X801.1 (EN); also elsewhere on the board
ETH_PHY_RESET: R801.1; also elsewhere on the board
ETH_RMII_CRSDV: R814.2; also elsewhere on the board
ETH_RMII_MDC: R816.2; also elsewhere on the board
ETH_RMII_MDCIO: R807.2, R815.2; also elsewhere on the board
ETH_RMII_REFCLK: R817.2; also elsewhere on the board
ETH_RMII_RXD0: R811.2; also elsewhere on the board
ETH_RMII_RXD1: R812.2; also elsewhere on the board
ETH_RMII_RXERR: R813.2; also elsewhere on the board
ETH_RMII_TXD0: R808.2; also elsewhere on the board
ETH_RMII_TXD1: R809.2; also elsewhere on the board
ETH_RMII_TXEN: R810.2; also elsewhere on the board
GND: C801.2, C802.2, C803.2, C804.2, C805.2, C806.2, C807.2, C808.2, C809.2, C810.2, C811.2, C812.2, Q801.2 (S), R803.2, R806.2, R818.2, R820.2, U801.2 (GND), U802.25 (VSS), X801.2 (GND); also elsewhere on the board
unnamed: C802.1, C803.1, C805.1, L801.1, X801.4 (Vdd)
unnamed: Q801.1 (G), R801.2, R802.2
unnamed: Q801.3 (D), R804.2, U802.15 (RST)
unnamed: R805.1, X801.3 (OUT)
unnamed: R808.1, U802.17 (TXD0)
unnamed: R809.1, U802.18 (TXD1)
unnamed: R810.1, U802.16 (TXEN)
unnamed: R811.1, U802.8 (RXD0/MODE0)
unnamed: R812.1, U802.7 (RXD1/MODE1)
unnamed: R813.1, U802.10 (RXER/PHYAD0)
unnamed: R814.1, U802.11 (CRS_DV/MODE2)
unnamed: R815.1, U802.12 (MDIO)
unnamed: R816.1, U802.13 (MDC)
unnamed: R817.1, U802.14 (INT/REFCLKO)
unnamed: R818.1, U802.24 (RBIAS)
PHY_LED1: R819.2, U802.3 (LED1/REGOFF); also elsewhere on the board
PHY_LED2: R820.1, U802.2 (LED2/nINTSEL); also elsewhere on the board
POS1P2_RUN: U801.3 (EN); also elsewhere on the board

Notes on the sheet:
The pin strap settings on LED1/LED2 disable the internal +1.2V core voltage regulator and enable REFCLK output The LED1 output is driven active whenever the device detects a valid link, and blinks when CRS is active (high) indicating activity. The LED2 output is driven active when the operating spe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
VDDCR
VDDIO
VDD1A
VDD2A

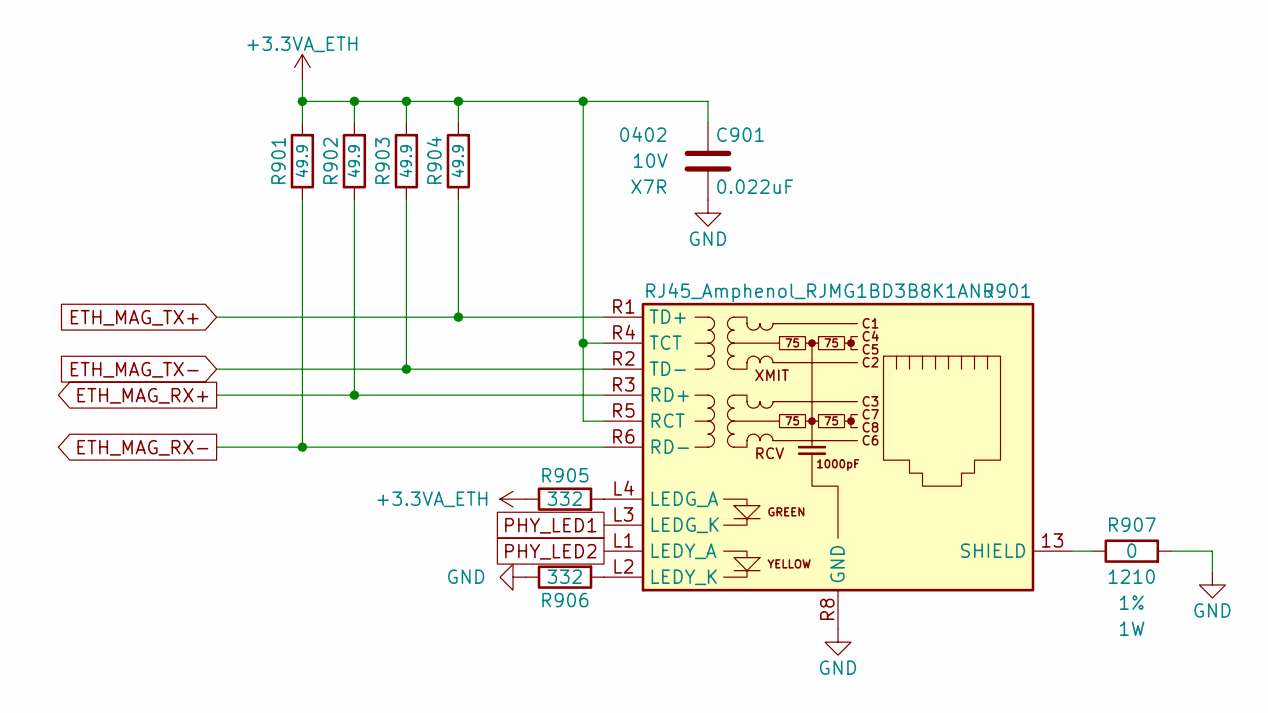
[picture p23: schematic Ethernet_Magnetics.sch]

Parts:
C901: 0.022uF; C_0402; Voltage 10V; Digi-Key PN 311-3793-1-ND
J901: RJ45_Amphenol_RJMG1BD3B8K1ANR; Digi-Key PN RJMG1BD3B8K1ANR-ND
R901, R902, R903, R904: 49.9; R_0402; Tolerance 1%; Digi-Key PN 541-3967-1-ND
R905, R906: 332; R_0402; Tolerance 1%; Digi-Key PN 541-332LCT-ND
R907: 0; R_1210; Tolerance 1%; Digi-Key PN RMCF1210ZT0R00CT-ND

Connections:
+3.3VA_ETH: C901.1, J901.R4 (TCT), J901.R5 (RCT), R901.1, R902.1, R903.1, R904.1, R905.2; also elsewhere on the board
ETH_MAG_RX+: J901.R3 (RD+), R902.2; also elsewhere on the board
ETH_MAG_RX-: J901.R6 (RD-), R901.2; also elsewhere on the board
ETH_MAG_TX+: J901.R1 (TD+), R904.2; also elsewhere on the board
ETH_MAG_TX-: J901.R2 (TD-), R903.2; also elsewhere on the board
GND: C901.2, J901.R8 (GND), R906.2, R907.1; also elsewhere on the board
unnamed: J901.13 (SHIELD), R907.2
unnamed: J901.L2 (LEDY_K), R906.1
unnamed: J901.L4 (LEDG_A), R905.1
PHY_LED1: J901.L3 (LEDG_K); also elsewhere on the board
PHY_LED2: J901.L1 (LEDY_A); also elsewhere on the board

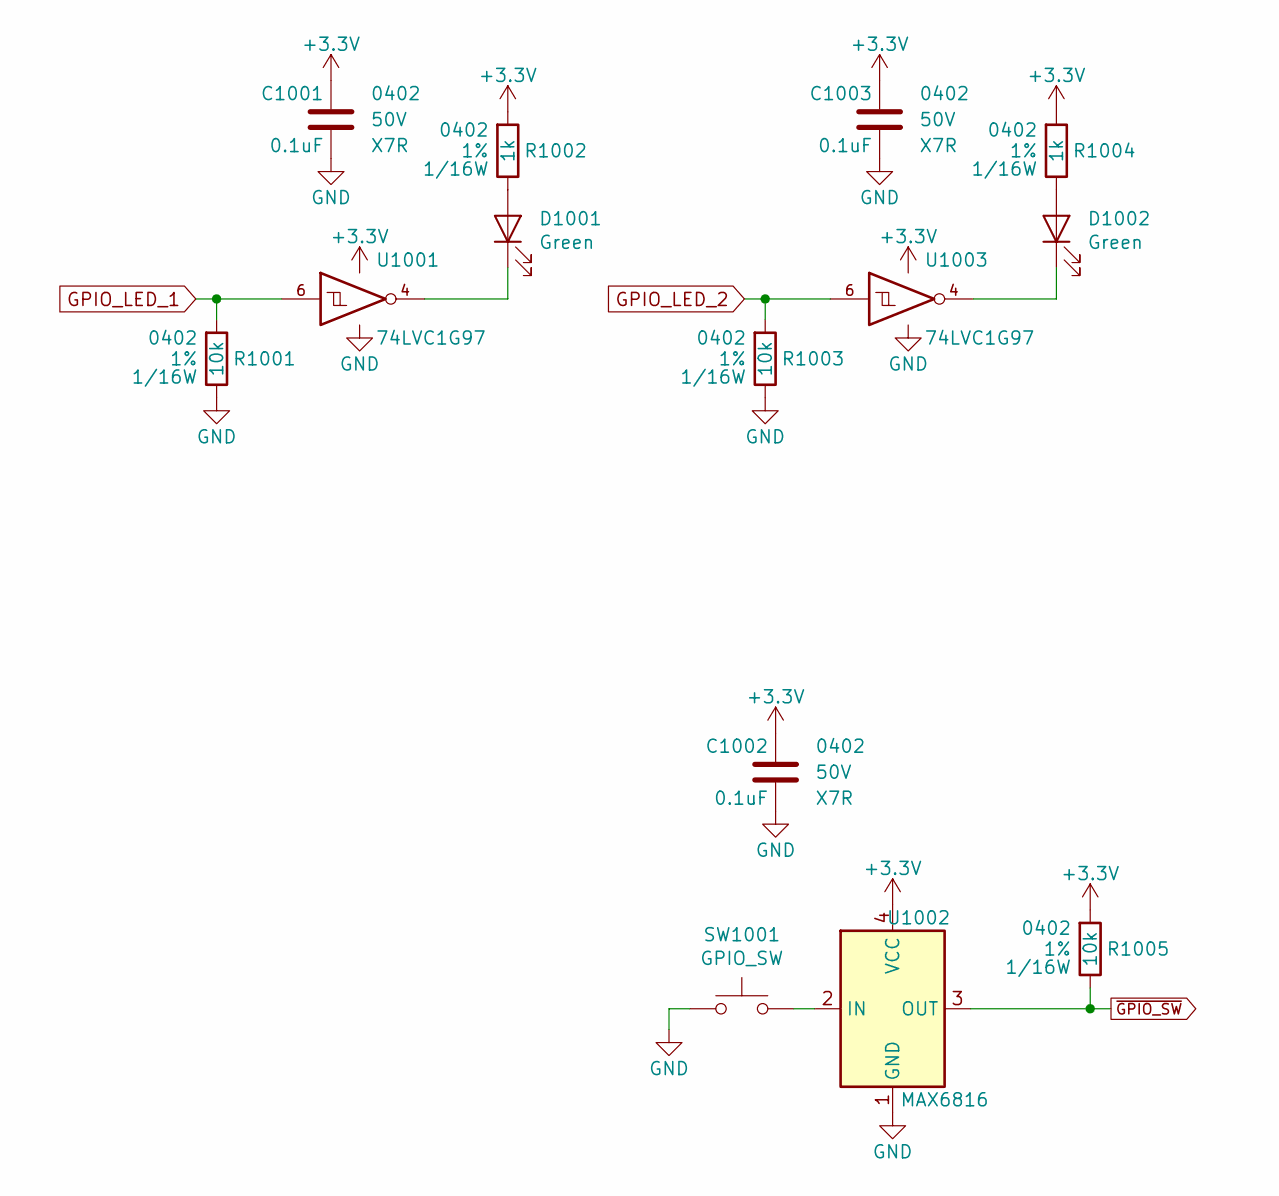
[picture p24: schematic GPIO.sch]

Parts:
C1001, C1002, C1003: 0.1uF; C_0402; Voltage 50V; Digi-Key PN 490-10701-1-ND
D1001, D1002: Green; LED_0402; Digi-Key PN 1497-1219-1-ND
R1001, R1003, R1005: 10k; R_0402; Tolerance 1%; Digi-Key PN RMCF0402FT10K0CT-ND
R1002, R1004: 1k; R_0402; Tolerance 1%; Digi-Key PN 541-1.00KLCT-ND
SW1001: GPIO_SW; SW_PUSH_6mm
U1001, U1003: 74LVC1G97; SOT-363_SC-70-6; Digi-Key PN 296-15582-1-ND
U1002: MAX6816; SOT-143; Digi-Key PN MAX6816EUS+TCT-ND

Connections:
+3V3: C1001.1, C1002.1, C1003.1, R1002.1, R1004.1, R1005.1, U1001.1 (VCC), U1001.5 (VCC), U1002.4 (VCC), U1003.1 (VCC), U1003.5 (VCC); also elsewhere on the board
GND: C1001.2, C1002.2, C1003.2, R1001.2, R1003.2, SW1001.1, U1001.2 (GND), U1001.3 (GND), U1002.1 (GND), U1003.2 (GND), U1003.3 (GND); also elsewhere on the board
GPIO_LED_1: R1001.1, U1001.6; also elsewhere on the board
GPIO_LED_2: R1003.1, U1003.6; also elsewhere on the board
unnamed: D1001.1 (K), U1001.4
unnamed: D1001.2 (A), R1002.2
unnamed: D1002.1 (K), U1003.4
unnamed: D1002.2 (A), R1004.2
unnamed: SW1001.2, U1002.2 (IN)
~GPIO_SW: R1005.2, U1002.3 (OUT); also elsewhere on the board

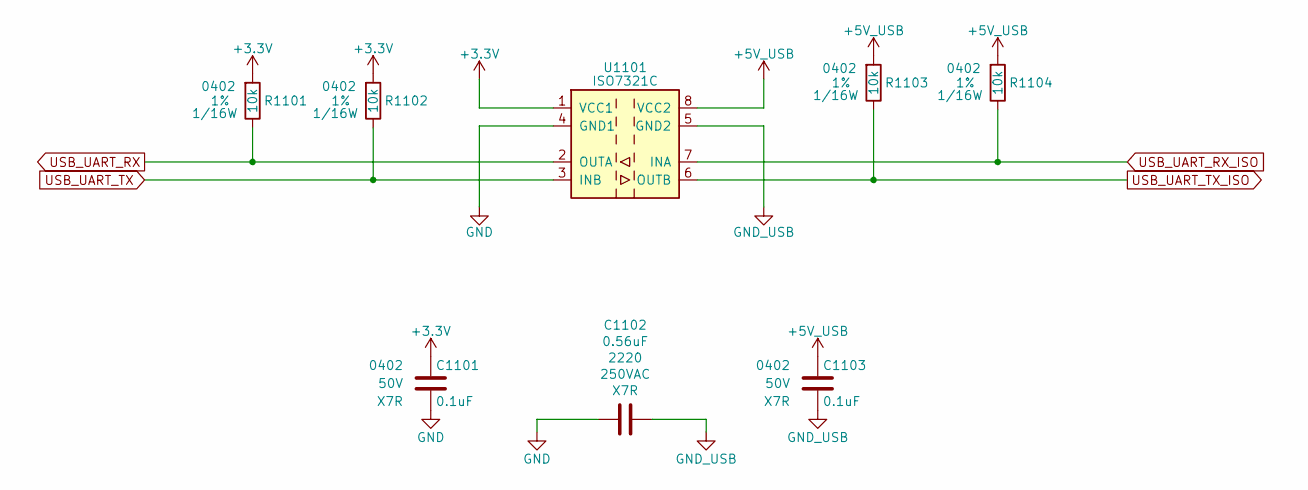
[picture p25: schematic USB_UART_Isolation.sch, VFD Clock]

Parts:
C1101, C1103: 0.1uF; C_0402; Voltage 50V; Digi-Key PN 490-10701-1-ND
C1102: 0.56uF; C_2220; Voltage 250VAC; Digi-Key PN 565-4707-1-ND
R1101, R1102, R1103, R1104: 10k; R_0402; Tolerance 1%; Digi-Key PN RMCF0402FT10K0CT-ND
U1101: ISO7321C; SOIC-8_3.9x4.9mm_Pitch1.27mm; Digi-Key PN 296-42102-1-ND

Connections:
+3V3: C1101.1, R1101.1, R1102.1, U1101.1 (VCC1); also elsewhere on the board
+5V_USB: C1103.1, R1103.1, R1104.1, U1101.8 (VCC2); also elsewhere on the board
GND: C1101.2, C1102.1, U1101.4 (GND1); also elsewhere on the board
GND_USB: C1102.2, C1103.2, U1101.5 (GND2); also elsewhere on the board
USB_UART_RX: R1101.2, U1101.2 (OUTA); also elsewhere on the board
USB_UART_RX_ISO: R1104.2, U1101.7 (INA); also elsewhere on the board
USB_UART_TX: R1102.2, U1101.3 (INB); also elsewhere on the board
USB_UART_TX_ISO: R1103.2, U1101.6 (OUTB); also elsewhere on the board
