drewsum/PIC32MZ_ETH_Demo/hdw/PIC32MZ_ETH_Demo/PIC32MZ_ETH_Demo.kicad_pcb

## KiCad design hdw/PIC32MZ_ETH_Demo/PIC32MZ_ETH_Demo.kicad_pcb (continued)

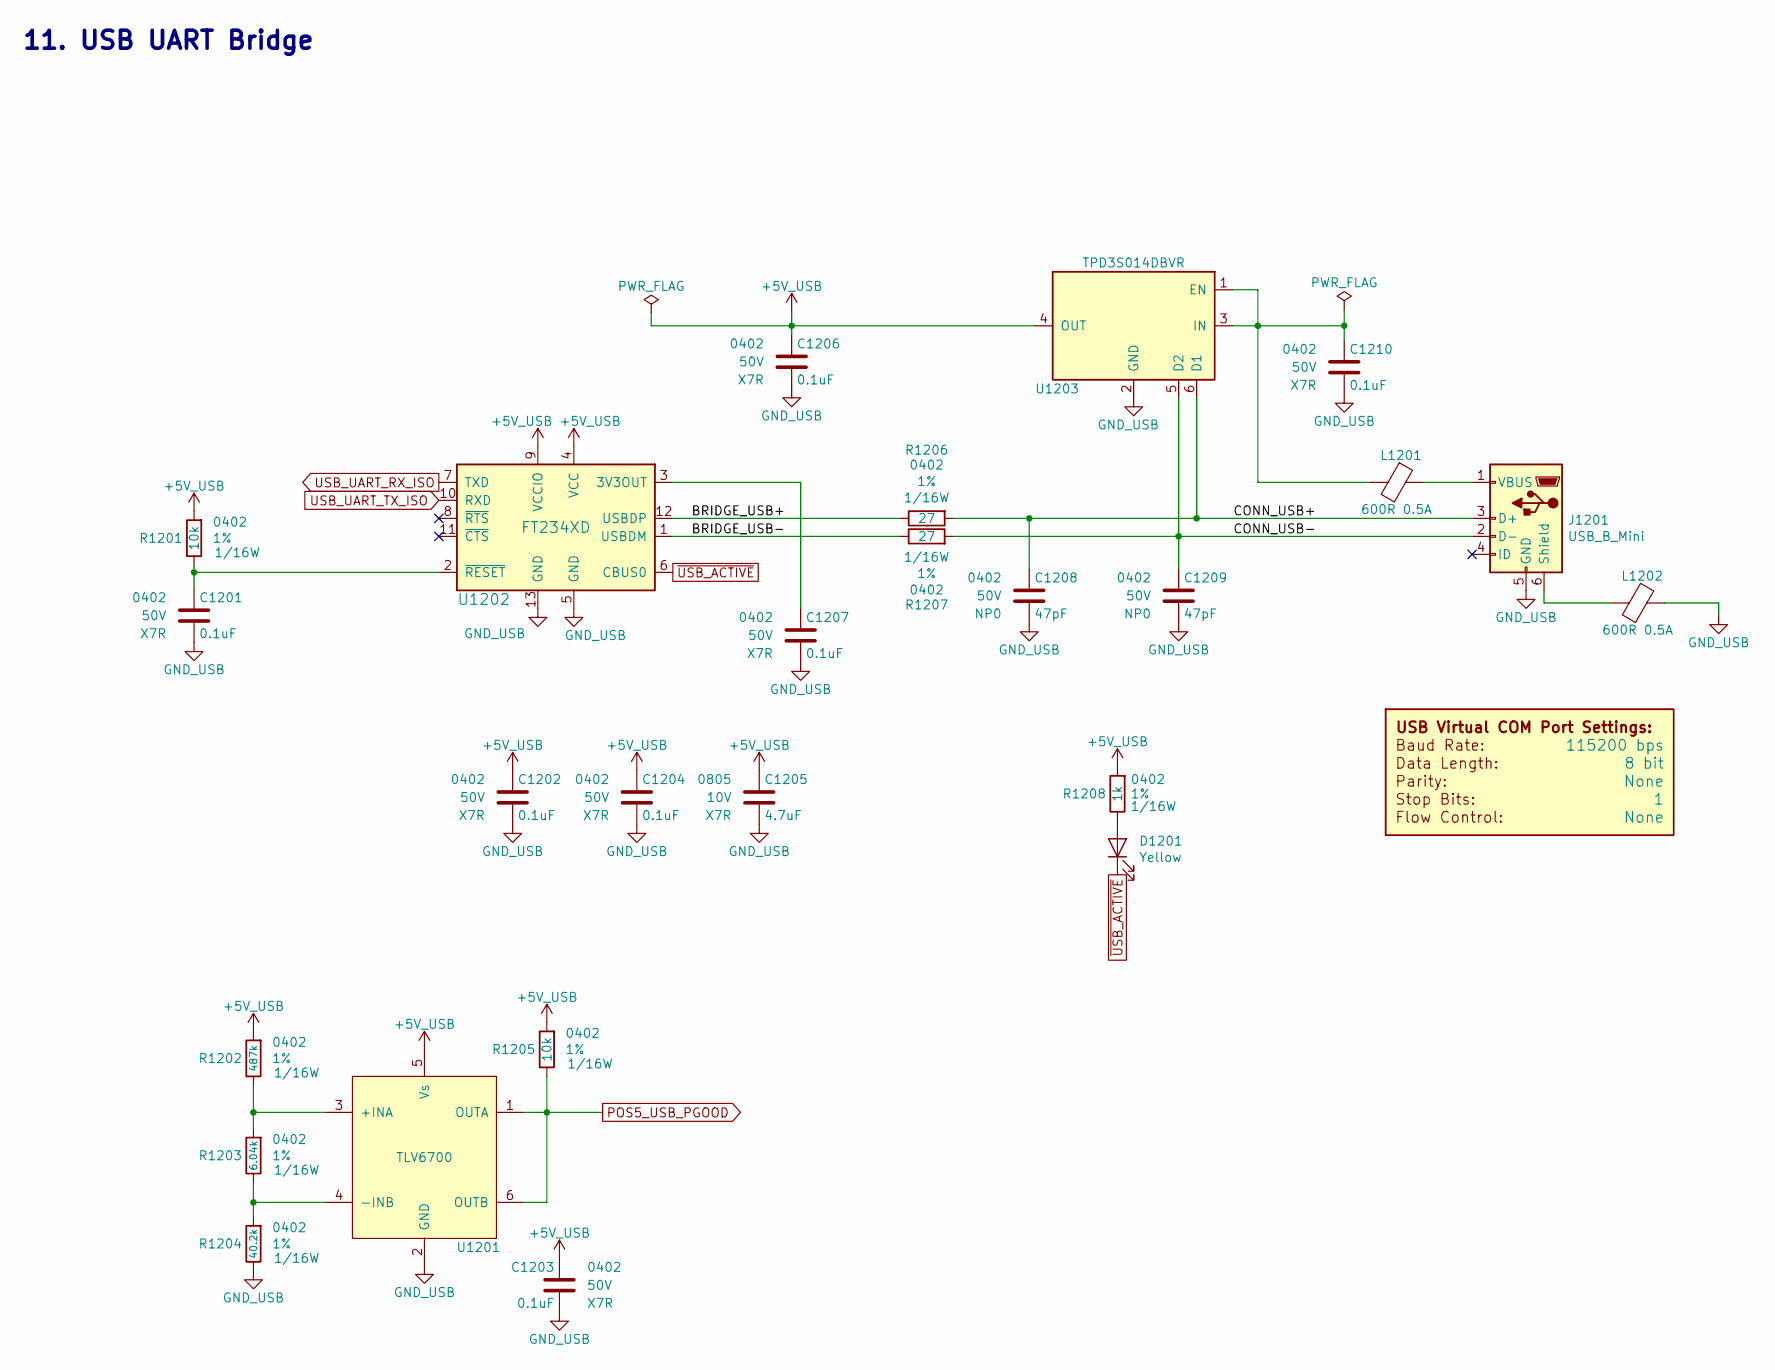
[picture p26: schematic USB_UART_Bridge.sch, VFD Clock]

Parts:
C1201, C1202, C1203, C1204, C1206, C1207, C1210: 0.1uF; C_0402; Voltage 50V; Digi-Key PN 490-10701-1-ND
C1205: 4.7uF; C_0805; Voltage 10V; Digi-Key PN 1276-2972-1-ND
C1208, C1209: 47pF; C_0402; Voltage 50V; Digi-Key PN 399-17558-1-ND
D1201: Yellow; LED_0402; Digi-Key PN 1497-1389-1-ND
DOC1201: COM_Port_Settings
J1201: USB_B_Mini; USB_Mini-B; Digi-Key PN 732-2109-1-ND
L1201, L1202: 600R 0.5A; L_0402; Digi-Key PN 490-5441-1-ND
R1201, R1205: 10k; R_0402; Tolerance 1%; Digi-Key PN RMCF0402FT10K0CT-ND
R1202: 487k; R_0402; Tolerance 1%; Digi-Key PN RMCF0402FT487KCT-ND
R1203: 6.04k; R_0402; Tolerance 1%; Digi-Key PN 541-4067-1-ND
R1204: 40.2k; R_0402; Tolerance 1%; Digi-Key PN 541-4097-1-ND
R1206, R1207: 27; R_0402; Tolerance 1%; Digi-Key PN 541-4082-1-ND
R1208: 1k; R_0402; Tolerance 1%; Digi-Key PN 541-1.00KLCT-ND
U1201: TLV6700; SOT-23-6; Digi-Key PN 296-51696-1-ND
U1202: FT234XD; DFN-12-1EP_3x3mm_Pitch0.45mm; Digi-Key PN 768-1178-1-ND
U1203: TPD3S014DBVR; SOT-23-6; Digi-Key PN 296-38835-1-ND

Connections:
+5V_USB: C1202.1, C1203.1, C1204.1, C1205.1, C1206.1, R1201.1, R1202.1, R1205.1, R1208.1, U1201.5 (Vs), U1202.4 (VCC), U1202.9 (VCCIO), U1203.4 (OUT); also elsewhere on the board
/USB UART Bridge/BRIDGE_USB+: R1206.2, U1202.12 (USBDP)
/USB UART Bridge/BRIDGE_USB-: R1207.2, U1202.1 (USBDM)
/USB UART Bridge/CONN_USB+: C1208.1, J1201.3 (D+), R1206.1, U1203.6 (D1)
/USB UART Bridge/CONN_USB-: C1209.1, J1201.2 (D-), R1207.1, U1203.5 (D2)
GND_USB: C1201.2, C1202.2, C1203.2, C1204.2, C1205.2, C1206.2, C1207.2, C1208.2, C1209.2, C1210.2, J1201.5 (GND), L1202.1, R1204.2, U1201.2 (GND), U1202.5 (GND), U1202.13 (GND), U1203.2 (GND); also elsewhere on the board
unnamed: C1201.1, R1201.2, U1202.2 (~RESET)
unnamed: C1207.1, U1202.3 (3V3OUT)
unnamed: C1210.1, L1201.2, U1203.1 (EN), U1203.3 (IN)
unnamed: D1201.2 (A), R1208.2
unnamed: J1201.1 (VBUS), L1201.1
unnamed: J1201.6 (Shield), L1202.2
unnamed: R1202.2, R1203.1, U1201.3 (+INA)
unnamed: R1203.2, R1204.1, U1201.4 (-INB)
POS5_USB_PGOOD: R1205.2, U1201.1 (OUTA), U1201.6 (OUTB); also elsewhere on the board
USB_UART_RX_ISO: U1202.7 (TXD); also elsewhere on the board
USB_UART_TX_ISO: U1202.10 (RXD); also elsewhere on the board
~USB_ACTIVE: D1201.1 (K), U1202.6 (CBUS0)

Notes on the sheet:
11. USB UART Bridge

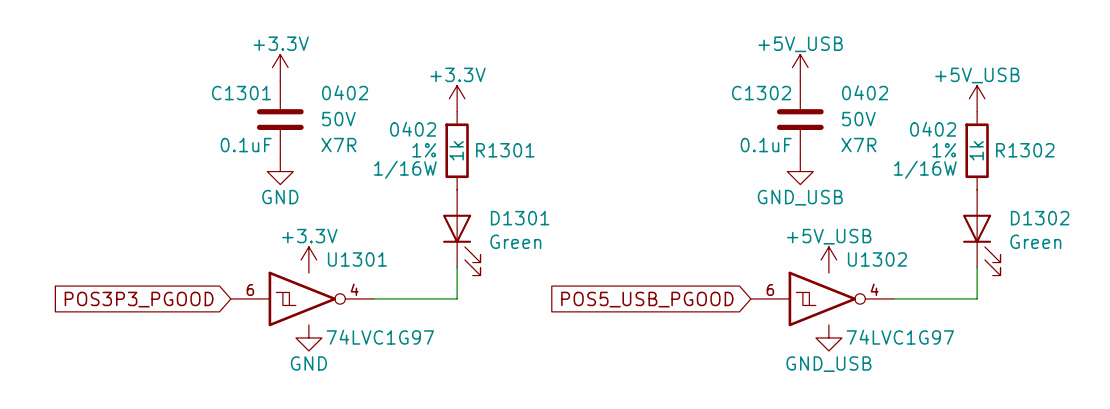
[picture p27: schematic PGOOD_LEDs.sch]

Parts:
C1301, C1302: 0.1uF; C_0402; Voltage 50V; Digi-Key PN 490-10701-1-ND
D1301, D1302: Green; LED_0402; Digi-Key PN 1497-1219-1-ND
R1301, R1302: 1k; R_0402; Tolerance 1%; Digi-Key PN 541-1.00KLCT-ND
U1301, U1302: 74LVC1G97; SOT-363_SC-70-6; Digi-Key PN 296-15582-1-ND

Connections:
+3V3: C1301.1, R1301.1, U1301.1 (VCC), U1301.5 (VCC); also elsewhere on the board
+5V_USB: C1302.1, R1302.1, U1302.1 (VCC), U1302.5 (VCC); also elsewhere on the board
GND: C1301.2, U1301.2 (GND), U1301.3 (GND); also elsewhere on the board
GND_USB: C1302.2, U1302.2 (GND), U1302.3 (GND); also elsewhere on the board
unnamed: D1301.1 (K), U1301.4
unnamed: D1301.2 (A), R1301.2
unnamed: D1302.1 (K), U1302.4
unnamed: D1302.2 (A), R1302.2
POS3P3_PGOOD: U1301.6; also elsewhere on the board
POS5_USB_PGOOD: U1302.6; also elsewhere on the board

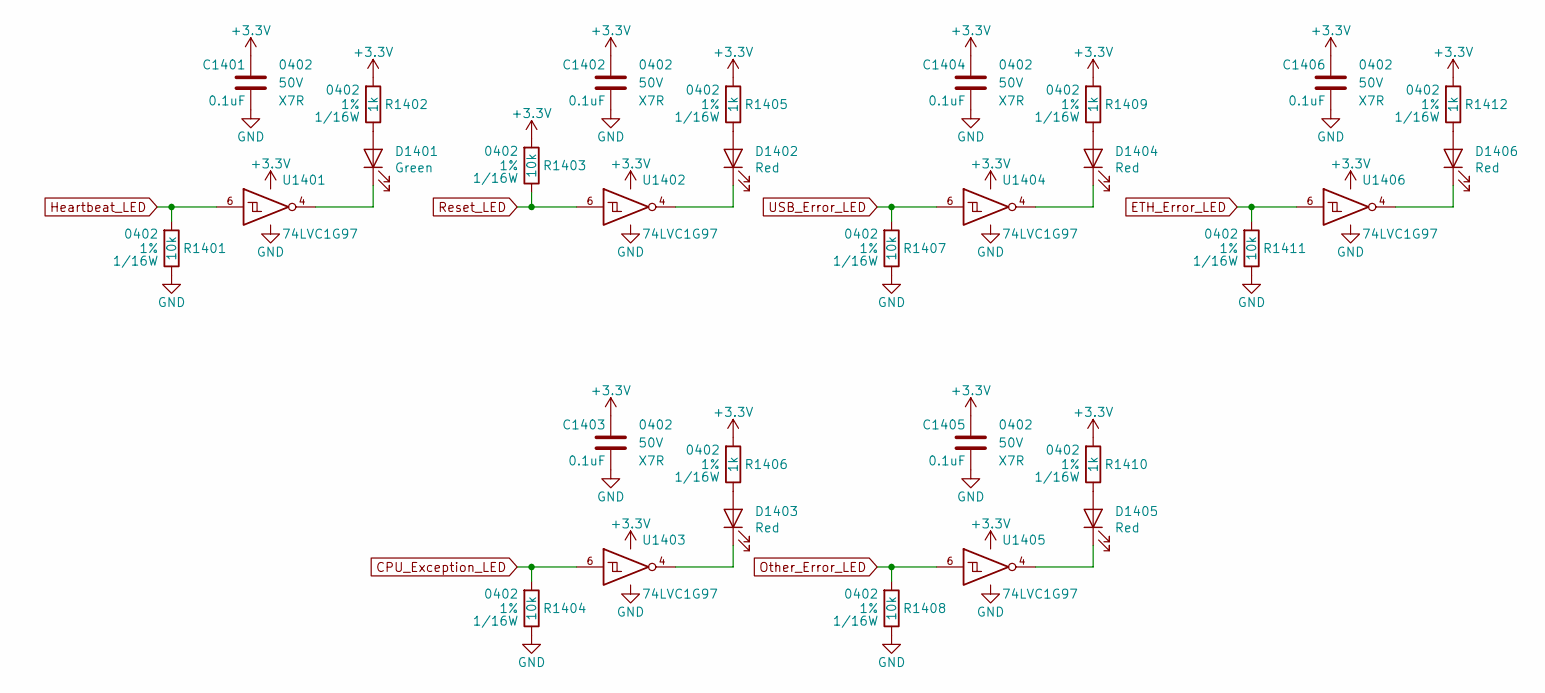
[picture p28: schematic Status_LEDs.sch]

Parts:
C1401, C1402, C1403, C1404, C1405, C1406: 0.1uF; C_0402; Voltage 50V; Digi-Key PN 490-10701-1-ND
D1401: Green; LED_0402; Digi-Key PN 1497-1219-1-ND
D1402, D1403, D1404, D1405, D1406: Red; LED_0402; Digi-Key PN 1497-1174-1-ND
R1401, R1403, R1404, R1407, R1408, R1411: 10k; R_0402; Tolerance 1%; Digi-Key PN RMCF0402FT10K0CT-ND
R1402, R1405, R1406, R1409, R1410, R1412: 1k; R_0402; Tolerance 1%; Digi-Key PN 541-1.00KLCT-ND
U1401, U1402, U1403, U1404, U1405, U1406: 74LVC1G97; SOT-363_SC-70-6; Digi-Key PN 296-15582-1-ND

Connections:
+3V3: C1401.1, C1402.1, C1403.1, C1404.1, C1405.1, C1406.1, R1402.1, R1403.1, R1405.1, R1406.1, R1409.1, R1410.1, R1412.1, U1401.1 (VCC), U1401.5 (VCC), U1402.1 (VCC), U1402.5 (VCC), U1403.1 (VCC), U1403.5 (VCC), U1404.1 (VCC), U1404.5 (VCC), U1405.1 (VCC), U1405.5 (VCC), U1406.1 (VCC), U1406.5 (VCC); also elsewhere on the board
CPU_Exception_LED: R1404.1, U1403.6; also elsewhere on the board
ETH_Error_LED: R1411.1, U1406.6; also elsewhere on the board
GND: C1401.2, C1402.2, C1403.2, C1404.2, C1405.2, C1406.2, R1401.2, R1404.2, R1407.2, R1408.2, R1411.2, U1401.2 (GND), U1401.3 (GND), U1402.2 (GND), U1402.3 (GND), U1403.2 (GND), U1403.3 (GND), U1404.2 (GND), U1404.3 (GND), U1405.2 (GND), U1405.3 (GND), U1406.2 (GND), U1406.3 (GND); also elsewhere on the board
Heartbeat_LED: R1401.1, U1401.6; also elsewhere on the board
unnamed: D1401.1 (K), U1401.4
unnamed: D1401.2 (A), R1402.2
unnamed: D1402.1 (K), U1402.4
unnamed: D1402.2 (A), R1405.2
unnamed: D1403.1 (K), U1403.4
unnamed: D1403.2 (A), R1406.2
unnamed: D1404.1 (K), U1404.4
unnamed: D1404.2 (A), R1409.2
unnamed: D1405.1 (K), U1405.4
unnamed: D1405.2 (A), R1410.2
unnamed: D1406.1 (K), U1406.4
unnamed: D1406.2 (A), R1412.2
Other_Error_LED: R1408.1, U1405.6; also elsewhere on the board
Reset_LED: R1403.2, U1402.6; also elsewhere on the board
USB_Error_LED: R1407.1, U1404.6; also elsewhere on the board

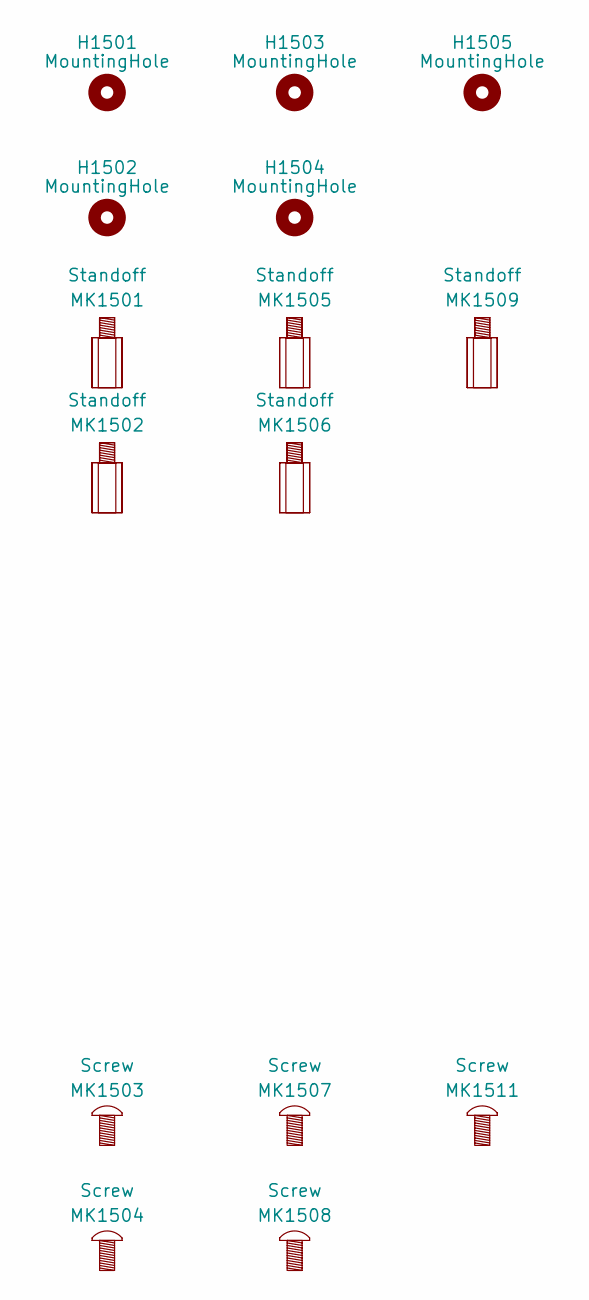
[picture p29: schematic Mechanical.sch, VFD Clock]

Parts:
H1501, H1502, H1503, H1504, H1505: MountingHole; MountingHole_3mm
MK1501, MK1502, MK1505, MK1506, MK1509: Standoff; Digi-Key PN 1772-2080-ND
MK1503, MK1504, MK1507, MK1508, MK1511: Screw; Digi-Key PN 36-9900-ND

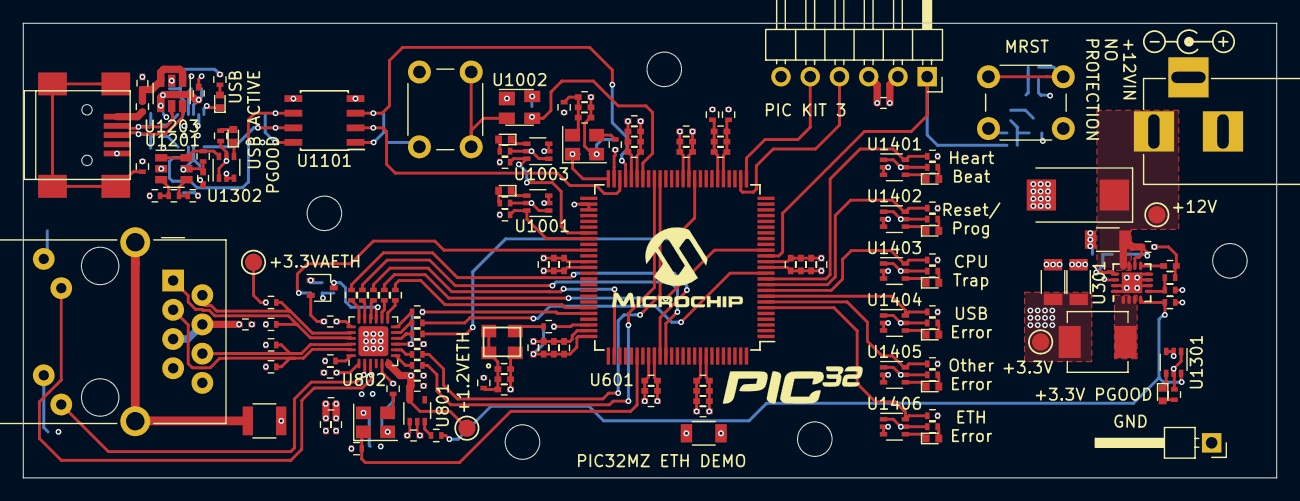
[picture p30: board PIC32MZ_ETH_Demo.kicad_pcb from above]

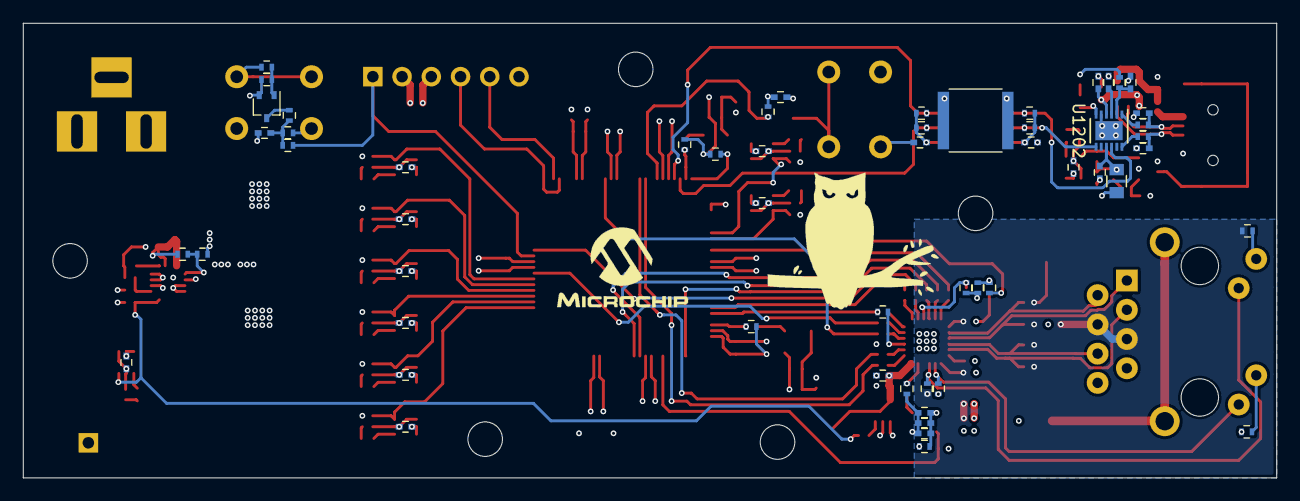
[picture p31: board PIC32MZ_ETH_Demo.kicad_pcb from below]

Board: 4 copper layers, 108.9 x 39.5 mm, 214 parts (56 on the bottom side), 114 nets.
