drewsum/PIC32MZ_ETH_Demo/sfw/U601_firmware/PIC32MZ_ETH_Demo.X/gpio_setup.c

#include <xc.h>

#include "gpio_setup.h"

// initializes GPIO ports on microcontroller
void gpioInitialize (void) {
    
    // Unlock peripheral pin select
    PPSUnlock();
    
    portAGPIOInitialize();
    portBGPIOInitialize();
    portCGPIOInitialize();
    portDGPIOInitialize();
    portEGPIOInitialize();
    portFGPIOInitialize();
    portGGPIOInitialize();
    
    // Lock PPS
    PPSLock();
    
}

// initializes port A GPIO pins
void portAGPIOInitialize (void) {
    
    // RA0
    ANSELAbits.ANSA0        = ANALOG_DISABLE;
    ODCAbits.ODCA0          = ODC_DISABLE;
    LATAbits.LATA0          = LAT_LOW;
    TRISAbits.TRISA0        = TRIS_OUTPUT;
    
    // RA1
    ANSELAbits.ANSA1        = ANALOG_DISABLE;
    ODCAbits.ODCA1          = ODC_DISABLE;
    LATAbits.LATA1          = LAT_LOW;
    TRISAbits.TRISA1        = TRIS_OUTPUT;
    
    
    // RA2
    ODCAbits.ODCA2          = ODC_DISABLE;
    LATAbits.LATA2          = LAT_LOW;
    TRISAbits.TRISA2        = TRIS_OUTPUT;
    
    
    // RA3
    ODCAbits.ODCA3         = ODC_DISABLE;
    LATAbits.LATA3          = LAT_LOW;
    TRISAbits.TRISA3        = TRIS_OUTPUT;
    
    
    // RA4
    ODCAbits.ODCA4          = ODC_DISABLE;
    LATAbits.LATA4          = LAT_LOW;
    TRISAbits.TRISA4        = TRIS_OUTPUT;
    
    
    // RA5
    ANSELAbits.ANSA5        = ANALOG_DISABLE;
    ODCAbits.ODCA5          = ODC_DISABLE;
    LATAbits.LATA5          = LAT_LOW;
    TRISAbits.TRISA5        = TRIS_OUTPUT;
    
    
    // RA6
    ODCAbits.ODCA6          = ODC_DISABLE;
    LATAbits.LATA6          = LAT_LOW;
    TRISAbits.TRISA6        = TRIS_OUTPUT;
    
    
    // RA7
    ODCAbits.ODCA7          = ODC_DISABLE;
    LATAbits.LATA7          = LAT_LOW;
    TRISAbits.TRISA7        = TRIS_OUTPUT;
    
    // RA9
    ANSELAbits.ANSA9        = ANALOG_DISABLE;
    ODCAbits.ODCA9          = ODC_DISABLE;
    LATAbits.LATA9          = LAT_LOW;
    TRISAbits.TRISA9        = TRIS_OUTPUT;
    
    
    // RA10
    ANSELAbits.ANSA10       = ANALOG_DISABLE;
    ODCAbits.ODCA10         = ODC_DISABLE;
    LATAbits.LATA10         = LAT_LOW;
    TRISAbits.TRISA10       = TRIS_OUTPUT;
    
    // RA14
    ODCAbits.ODCA14         = ODC_DISABLE;
    LATAbits.LATA14         = LAT_LOW;
    TRISAbits.TRISA14       = TRIS_OUTPUT;
    
    // RA15
    ODCAbits.ODCA15         = ODC_DISABLE;
    LATAbits.LATA15         = LAT_LOW;
    TRISAbits.TRISA15       = TRIS_OUTPUT;
    
}

// initializes port B GPIO pins
void portBGPIOInitialize (void) {
    
    // RB0
    ANSELBbits.ANSB0        = ANALOG_DISABLE;
    ODCBbits.ODCB0          = ODC_DISABLE;
    LATBbits.LATB0          = LAT_LOW;
    TRISBbits.TRISB0        = TRIS_OUTPUT;
    
    // RB1
    ANSELBbits.ANSB1        = ANALOG_DISABLE;
    ODCBbits.ODCB1          = ODC_DISABLE;
    LATBbits.LATB1          = LAT_LOW;
    TRISBbits.TRISB1        = TRIS_OUTPUT;
    
    // RB2
    ANSELBbits.ANSB2        = ANALOG_DISABLE;
    ODCBbits.ODCB2          = ODC_DISABLE;
    LATBbits.LATB2          = LAT_LOW;
    TRISBbits.TRISB2        = TRIS_OUTPUT;
    
    // RB3
    ANSELBbits.ANSB3        = ANALOG_DISABLE;
    ODCBbits.ODCB3          = ODC_DISABLE;
    LATBbits.LATB3          = LAT_LOW;
    TRISBbits.TRISB3        = TRIS_OUTPUT;
    
    // RB4
    ANSELBbits.ANSB4        = ANALOG_DISABLE;
    ODCBbits.ODCB4          = ODC_DISABLE;
    LATBbits.LATB4          = LAT_LOW;
    TRISBbits.TRISB4        = TRIS_OUTPUT;
    
    // RB5
    ANSELBbits.ANSB5        = ANALOG_DISABLE;
    ODCBbits.ODCB5          = ODC_DISABLE;
    LATBbits.LATB5          = LAT_LOW;
    TRISBbits.TRISB5        = TRIS_OUTPUT;
    
    // RB6
    ANSELBbits.ANSB6        = ANALOG_DISABLE;
    ODCBbits.ODCB6          = ODC_DISABLE;
    LATBbits.LATB6          = LAT_LOW;
    TRISBbits.TRISB6        = TRIS_OUTPUT;
    
    // RB7
    ANSELBbits.ANSB7        = ANALOG_DISABLE;
    ODCBbits.ODCB7          = ODC_DISABLE;
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
    // RG13
    ODCGbits.ODCG13         = ODC_DISABLE;
    LATGbits.LATG13         = LAT_LOW;
    TRISGbits.TRISG13       = TRIS_OUTPUT;
    
    // RG14
    ODCGbits.ODCG14         = ODC_DISABLE;
    LATGbits.LATG14         = LAT_LOW;
    TRISGbits.TRISG14       = TRIS_OUTPUT;
    
    // RG15
    ANSELGbits.ANSG15       = ANALOG_DISABLE;
    ODCGbits.ODCG15         = ODC_DISABLE;
    LATGbits.LATG15         = LAT_LOW;
    TRISGbits.TRISG15       = TRIS_OUTPUT;
    
}
