drewsum/PIC32MZ_ETH_Demo/(commit log)

2020-03-12 Added hardware project, started schematic
    [Ethernet_Magnetics.sch, Ethernet_PHY.sch, GPIO.sch, Mechanical.sch, PGOOD_LEDs.sch, PIC32MZ.sch, PIC32MZ_Bypass.sch, PIC32MZ_Clocking.sch]
2020-03-29 More schematic tweaks, followed PHY design guide
    [Ethernet_Magnetics.sch, Ethernet_PHY.sch, GPIO.sch, Mechanical.sch, PGOOD_LEDs.sch, PIC32MZ.sch, PIC32MZ_Bypass.sch, PIC32MZ_Clocking.sch]
2020-04-05 Populated digi-key pn's
    [Ethernet_Magnetics.sch, Ethernet_PHY.sch, GPIO.sch, PGOOD_LEDs.sch, PIC32MZ_Bypass.sch, PIC32MZ_Clocking.sch, PIC32MZ_Programming.sch, POS12_Input.sch]
2020-04-05 Started arranging parts on PCB
    [PIC32MZ_Bypass.sch, PIC32MZ_ETH_Demo.kicad_pcb, USB_UART_Bridge.sch]
2020-04-06 Added BOM, finished arranging parts
    [PIC32MZ_ETH_Demo.csv, PIC32MZ_ETH_Demo.kicad_pcb, PIC32MZ_ETH_Demo_BOM.xlsx]
2020-04-10 Finished board layout
    [Mechanical.sch, PIC32MZ.sch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]
2020-06-10 finished board
    [PIC32MZ_ETH_Demo.kicad_pcb, PIC32MZ_ETH_Demo_BOM.xlsx]
2020-06-10 Added MCU firmware project
    [configuration.h]
2020-06-10 Added pin macros, device control, other early stuff
2020-06-10 added pin macros, gpio setup
